davidstirling777-star/Underwater-Hockey-Scoring-Desk-Kit/hardware/Enclosures/UWH_Siren/UWH_Siren_Pipe_Adaptor.step

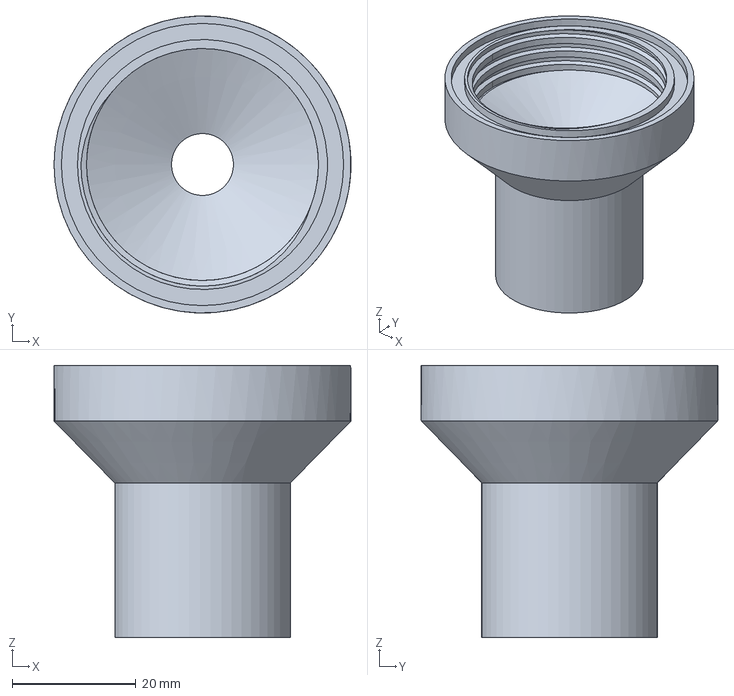
[picture p3: CAD file, 2026-11-10]
hardware/Enclosures/UWH_Siren/UWH_Siren_Pipe_Adaptor.step
48.0 x 48.0 x 44.0 mm
