davidstirling777-star/Underwater-Hockey-Scoring-Desk-Kit/(threads)

Thread 45 (2025-09-18):

create Zigbee/WiFi communications

davidstirling777-star, 2025-09-18:
no idea how to do this, I have a sonoff zigbee dongle to play with, but as of 18 September 2025, no zigbee buttons.  Should we just use the WIFI capability of the RP5 and use wifi buttons?

davidstirling777-star, 2025-09-26:
import subprocess

SSID = "UWH"
PASSWORD = "stickandpuck"
INTERFACE = "wlan0"  # Change if your Wi-Fi interface is different

def create_wifi_hotspot(ssid, password, interface):
    try:
        subprocess.run(['rfkill', 'unblock', 'wifi'], check=True)
        subprocess.run(['nmcli', 'radio', 'wifi', 'on'], check=True)
        subprocess.run([
            'nmcli', 'device', 'wifi', 'hotspot',
            'ifname', interface,
            'ssid', ssid,
            'password', password
        ], check=True)
        print(f"Hotspot '{ssid}' created with password '{password}' on {interface}.")
    except subprocess.CalledProcessError as e:
        print(f"Failed to create hotspot: {e}")

if __name__ == "__main__":
    create_wifi_hotspot(SSID, PASSWORD, INTERFACE)

Closed 2025-09-26.

Thread 54 (2025-09-20):

Starting a game at a set time

davidstirling777-star, 2025-09-20:
At the moment the app just starts the game sequence after Between Game Break value.

It would be nice to be able to set a time that the game started at and get the app to count down to that time, but actually swapping over to Between Game Break at that variables value before the scheduled start time,

eg, Current time is 7:15 am, Games start at 8:00 am, countdown timer displays 45:00 (mm:ss) but at 7:55 am the app swaps into Between Game Break as this value is set to (say) 5 minutes,

Thread 56 (2025-09-20):

Ability to 'step-through" a game

davidstirling777-star, 2025-09-20:
Occasionally things will get stuffed up by the score keeper so there should be a way of coping with the situation where say, game 64, a goal was inadvertently added in the last seconds of the game or overtime break (or Sudden Death Game Break) that tied the scores and the game progresses to Between Game Break, rather than Overtime Game Break.
Maybe a text box in the Game variables page where the game number could be entered and an advance button to step through the game sequence, then a GAME PAUSED/ ADD GOALS button appears on the Scoreboard screen so the score can be recreated, before the button is pushed (and vanishes) and a short countdown timer appears (say 10 seconds) with sound pips?

davidstirling777-star, 2025-10-06:
I don't think the current system has any ability to step through a game.  Like this system, it can start at a particular game from a list.
