davidstirling777-star/Underwater-Hockey-Scoring-Desk-Kit/hardware/Boards/DC-DC PDM-Audio/DC-DC PDM-Audio.kicad_pcb

## KiCad design hardware/Boards/DC-DC PDM-Audio/DC-DC PDM-Audio.kicad_pcb (2026-11-12)

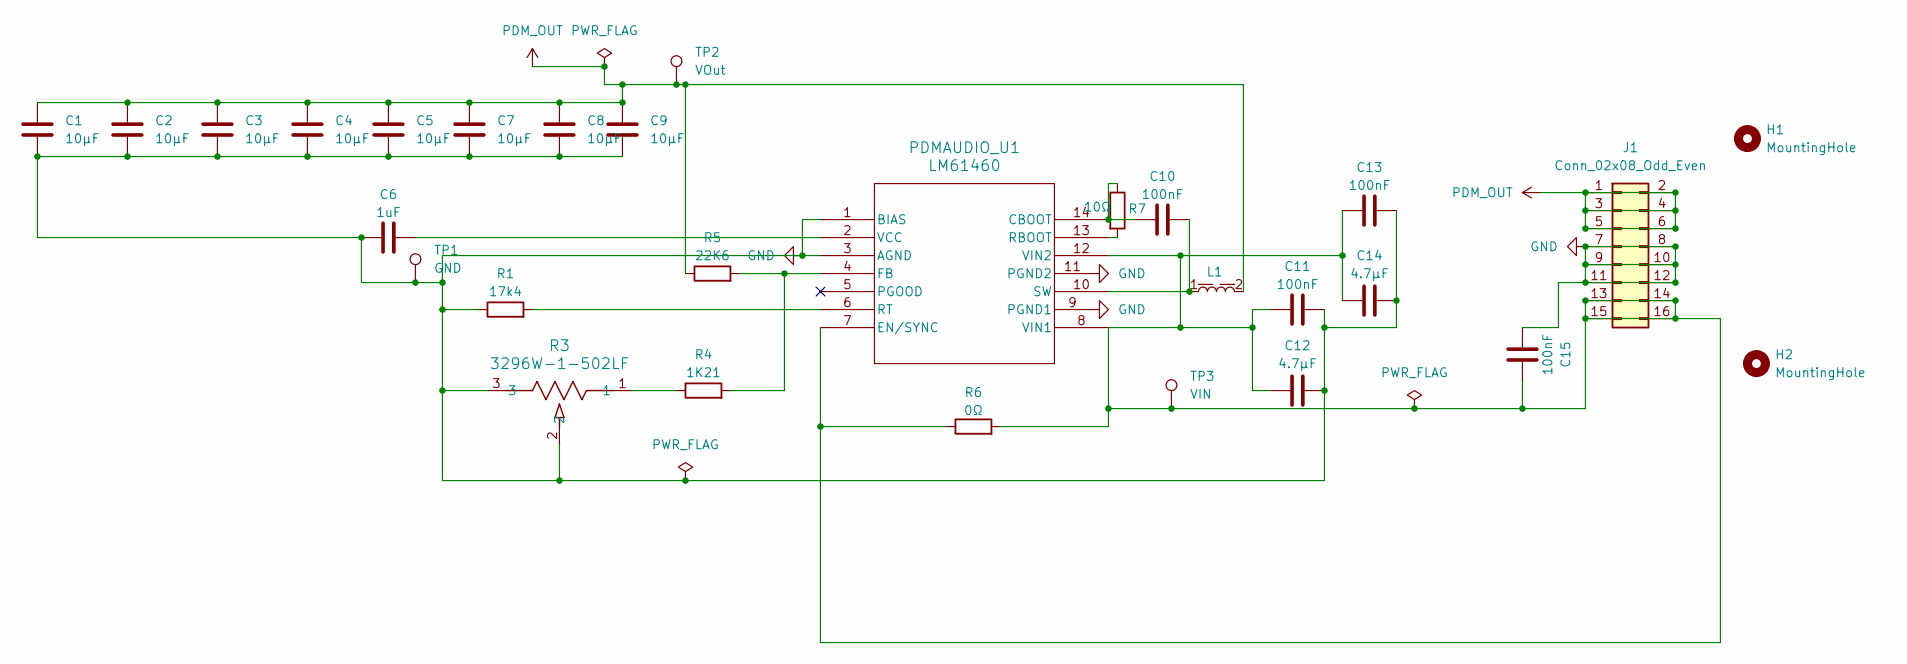
[picture p4: schematic DC-DC PDM-Audio.kicad_sch]

Parts:
C1, C2, C3, C4, C5, C7, C8, C9: 10µF; C_1210_3225Metric; MPN GRJ32ER71H106KE11K
C6: 1uF; C_0603_1608Metric; MPN GCM188R71C105KA64D
C10: 100nF; C_0805_2012Metric; MPN GCM21BR71H104KA37L
C11, C13, C15: 100nF; C_0603_1608Metric; MPN GCM188R71H104KA57D
C12, C14: 4.7µF; C_1206_3216Metric; MPN GRM31CR71H475KA12L
H1, H2: MountingHole; MountingHole_3.2mm_M3
J1: Conn_02x08_Odd_Even; PinHeader_2x08_P2.54mm_Vertical; MPN TSW-108-07-F-D
L1: 744393665100; Wurth_744393665100_WE-XHMI_1060; MPN 744393665100
PDMAUDIO_U1: LM61460; VQFN-HR14_RJR_TEX; MPN LMQ61460AFSQRJRRQ1
R1: 17k4; R_0603_1608Metric; MPN RC0603FR-0717K4L
R3: 3296W-1-502LF; Potentiometer_Bourns_3296W_Vertical; MPN 3296W-1-502LF
R4: 1K21; R_0603_1608Metric_Pad0.98x0.95mm_HandSolder; MPN RT0603BRE071K21L
R5: 22K6; R_0603_1608Metric_Pad0.98x0.95mm_HandSolder; MPN RT0603BRD0722K6L
R6: 0Ω; R_0603_1608Metric; MPN RC0603JR-070RL
R7: 10Ω; R_0603_1608Metric; MPN AC0603FR-0710RL
TP1: GND; TestPoint_Pad_D1.5mm
TP2: VOut; TestPoint_Pad_D1.5mm
TP3: VIN; TestPoint_Pad_D1.5mm

Connections:
GND: C1.2, C2.2, C3.2, C4.2, C5.2, C6.1, C7.2, C8.2, C9.2, C11.2, C12.2, C13.2, C14.2, C15.1, J1.7, J1.8, J1.9, J1.10, J1.11, J1.12, PDMAUDIO_U1.1 (BIAS), PDMAUDIO_U1.3 (AGND), PDMAUDIO_U1.9 (PGND1), PDMAUDIO_U1.11 (PGND2), R1.1, R3.2, R3.3, TP1.1 (1_1)
unnamed: C11.1, C12.1, C13.1, C14.1, C15.2, J1.13, J1.14, J1.15, J1.16, PDMAUDIO_U1.7 (EN/SYNC), PDMAUDIO_U1.8 (VIN1), PDMAUDIO_U1.12 (VIN2), R6.1, R6.2, TP3.1 (1_1)
unnamed: C10.1, PDMAUDIO_U1.14 (CBOOT), R7.1
unnamed: PDMAUDIO_U1.4 (FB), R4.2, R5.2
unnamed: PDMAUDIO_U1.13 (RBOOT), R7.2
unnamed: PDMAUDIO_U1.6 (RT), R1.2
unnamed: C10.2, L1.1, PDMAUDIO_U1.10 (SW)
unnamed: C6.2, PDMAUDIO_U1.2 (VCC)
unnamed: R3.1, R4.1
PDM_OUT: C1.1, C2.1, C3.1, C4.1, C5.1, C7.1, C8.1, C9.1, J1.1, J1.2, J1.3, J1.4, J1.5, J1.6, L1.2, R5.1, TP2.1 (1_1)

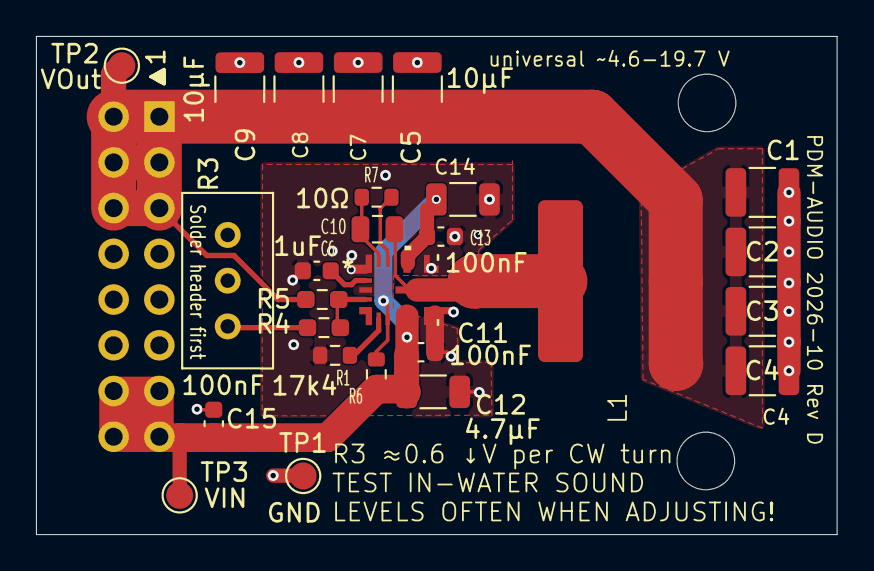
[picture p5: board DC-DC PDM-Audio.kicad_pcb from above]

Board: 2 copper layers, 44.5 x 27.7 mm, 29 parts (1 on the bottom side), 10 nets.
