davidstirling777-star/Underwater-Hockey-Scoring-Desk-Kit/hardware/Boards/UWH Power Board/UWH Power Board.kicad_pcb

## KiCad design hardware/Boards/UWH Power Board/UWH Power Board.kicad_pcb (2026-11-08)

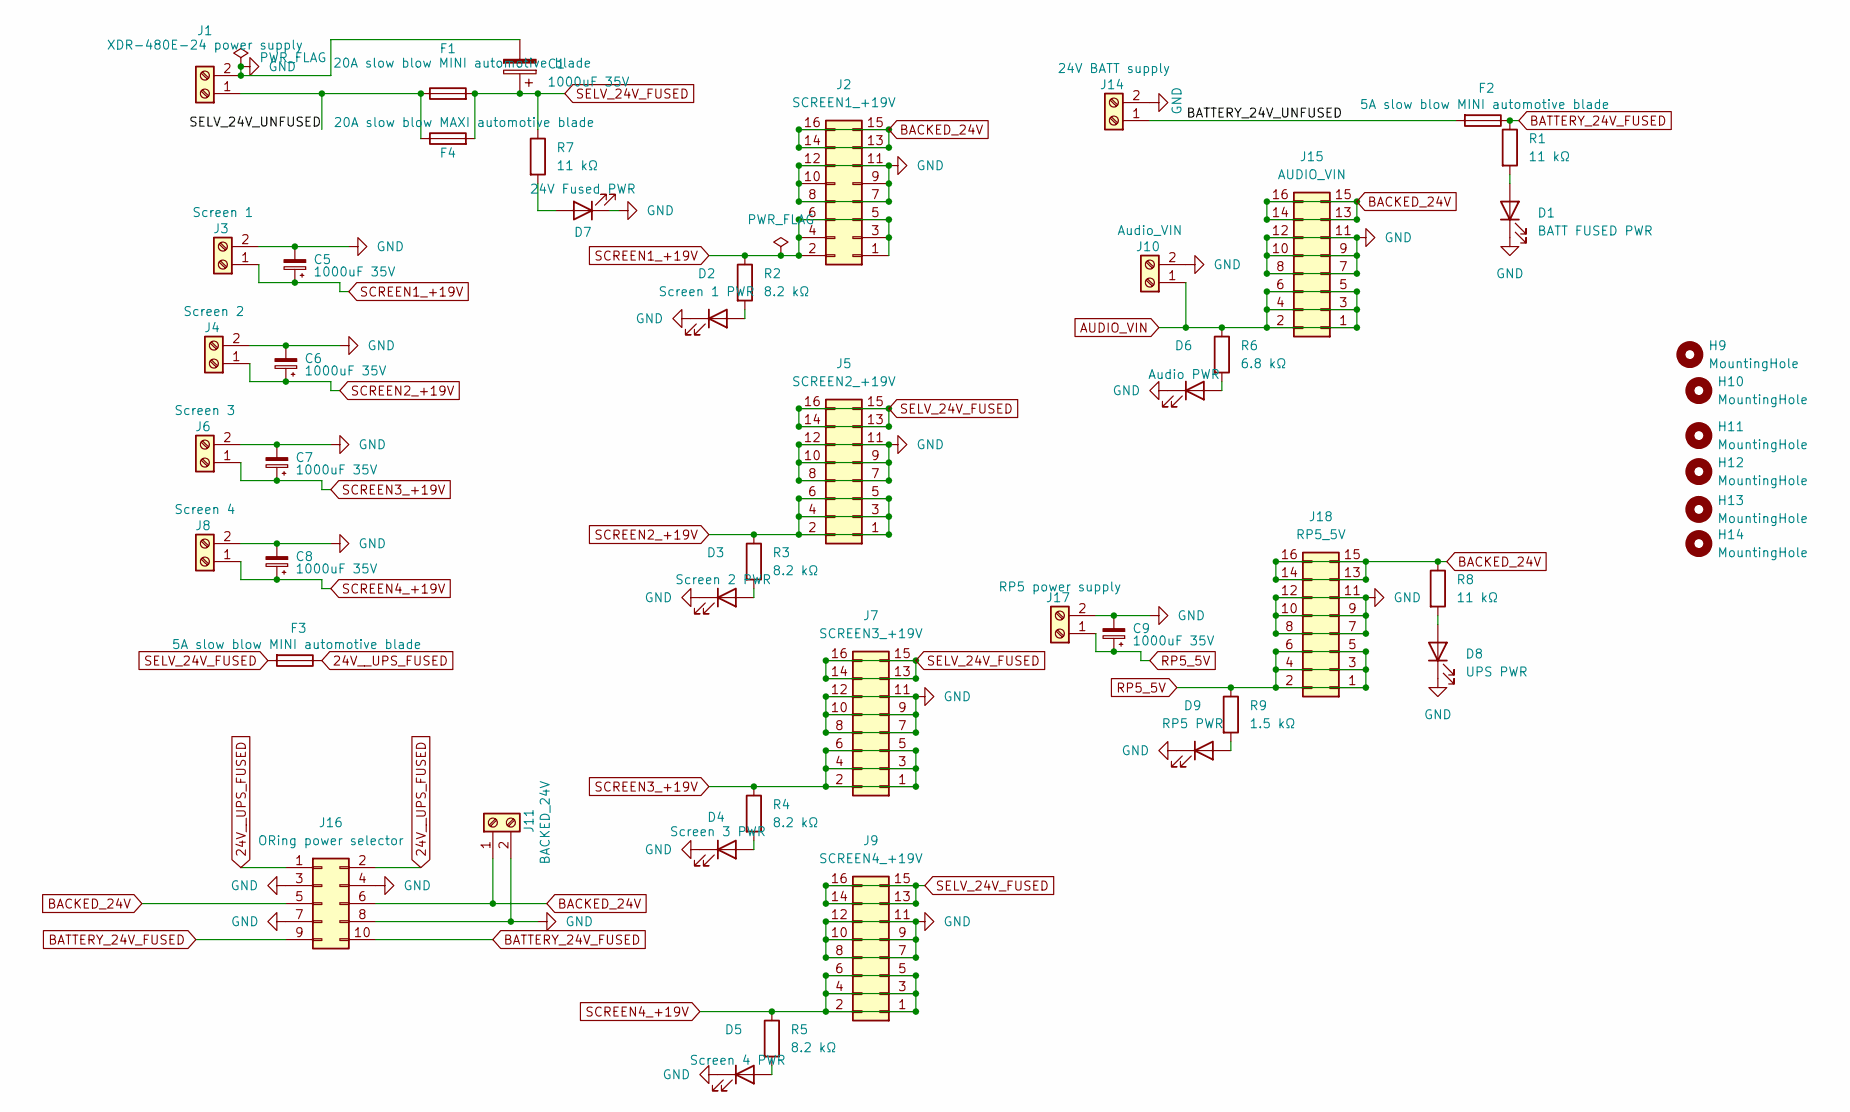
[picture p6: schematic UWH Power Board.kicad_sch]

Parts:
C1, C5, C6, C7, C8, C9: 1000uF 35V; CP_Radial_D12.5mm_P5.00mm; MPN 35ZLH1000MEFC12.5X20
D1: BATT FUSED PWR; LED_D3.0mm; MPN WP710A10LCGDK
D2: Screen 1 PWR; LED_D3.0mm; MPN WP710A10LCGDK
D3: Screen 2 PWR; LED_D3.0mm; MPN WP710A10LCGDK
D4: Screen 3 PWR; LED_D3.0mm; MPN WP710A10LCGDK
D5: Screen 4 PWR; LED_D3.0mm; MPN WP710A10LCGDK
D6: Audio PWR; LED_D3.0mm; MPN WP710A10LCGDK
D7: 24V Fused PWR; LED_D3.0mm; MPN WP710A10LCGDK
D8: UPS PWR; LED_D3.0mm; MPN WP710A10LCGDK
D9: RP5 PWR; LED_D3.0mm; MPN WP710A10LCGDK
F1: 20A slow blow MINI automotive blade; Fuseholder_Blade_Mini_Keystone_3568; MPN 3568
F2, F3: 5A slow blow MINI automotive blade; Fuseholder_Blade_Mini_Keystone_3568; MPN 3568
F4: 20A slow blow MAXI automotive blade; Fuseholder_Keystone_3555-2; MPN 3555-2
H9, H10, H11, H12, H13, H14: MountingHole; MountingHole_3.2mm_M3_Clearance7.2mm
J1: XDR-480E-24 power supply; CONN_1714971_PXC; MPN 1714971
J2: SCREEN1_+19V; PinSocket_2x08_P2.54mm_Vertical; MPN SSW-108-02-G-D
J3: Screen 1; TerminalBlock_CUI_TB007-508-02_1x02_P5.08mm_Horizontal; MPN TB007-508-02BE
J4: Screen 2; TerminalBlock_CUI_TB007-508-02_1x02_P5.08mm_Horizontal; MPN TB007-508-02BE
J5: SCREEN2_+19V; PinSocket_2x08_P2.54mm_Vertical; MPN SSW-108-02-G-D
J6: Screen 3; TerminalBlock_CUI_TB007-508-02_1x02_P5.08mm_Horizontal; MPN TB007-508-02BE
J7: SCREEN3_+19V; PinSocket_2x08_P2.54mm_Vertical; MPN SSW-108-02-G-D
J8: Screen 4; TerminalBlock_CUI_TB007-508-02_1x02_P5.08mm_Horizontal; MPN TB007-508-02BE
J9: SCREEN4_+19V; PinSocket_2x08_P2.54mm_Vertical; MPN SSW-108-02-G-D
J10: Audio_VIN; TerminalBlock_CUI_TB007-508-02_1x02_P5.08mm_Horizontal; MPN TB007-508-02BE
J11: BACKED_24V; TerminalBlock_CUI_TB007-508-02_1x02_P5.08mm_Horizontal; MPN TB007-508-02BE
J14: 24V BATT supply; TerminalBlock_CUI_TB007-508-02_1x02_P5.08mm_Horizontal; MPN TB007-508-02BE
J15: AUDIO_VIN; PinSocket_2x08_P2.54mm_Vertical; MPN SSW-108-02-G-D
J16: ORing power selector; ORing_Socket_SSW-105-02-G-D_v5; MPN SSW-105-02-G-D
J17: RP5 power supply; TerminalBlock_CUI_TB007-508-02_1x02_P5.08mm_Horizontal; MPN TB007-508-02BE
J18: RP5_5V; PinSocket_2x08_P2.54mm_Vertical; MPN SSW-108-02-G-D
R1, R7, R8: 11 kΩ; R_Axial_DIN0207_L6.3mm_D2.5mm_P7.62mm_Horizontal; MPN MFR-25FRF52-11K
R2, R3, R4, R5: 8.2 kΩ; R_Axial_DIN0207_L6.3mm_D2.5mm_P7.62mm_Horizontal; MPN MFR-25FRF52-8K2
R6: 6.8 kΩ; R_Axial_DIN0207_L6.3mm_D2.5mm_P7.62mm_Horizontal; MPN MFR-25FRF52-6K8
R9: 1.5 kΩ; R_Axial_DIN0207_L6.3mm_D2.5mm_P7.62mm_Horizontal; MPN MFR-25FRF52-1K5

Connections:
24V__UPS_FUSED: F3.1, J16.1, J16.2
/BATTERY_24V_UNFUSED: F2.2, J14.1
/SELV_24V_UNFUSED: F1.1, F4.1, J1.1
AUDIO_VIN: J10.1, J15.1, J15.2, J15.3, J15.4, J15.5, J15.6, R6.1
BACKED_24V: J2.13, J2.14, J2.15, J2.16, J11.1, J15.13, J15.14, J15.15, J15.16, J16.5, J16.6, J18.13, J18.14, J18.15, J18.16, R8.1
BATTERY_24V_FUSED: F2.1, J16.9, J16.10, R1.1
GND: C1.2, C5.2, C6.2, C7.2, C8.2, C9.2, D1.1 (K), D2.1 (K), D3.1 (K), D4.1 (K), D5.1 (K), D6.1 (K), D7.1 (K), D8.1 (K), D9.1 (K), J1.2, J2.7, J2.8, J2.9, J2.10, J2.11, J2.12, J3.2, J4.2, J5.7, J5.8, J5.9, J5.10, J5.11, J5.12, J6.2, J7.7, J7.8, J7.9, J7.10, J7.11, J7.12, J8.2, J9.7, J9.8, J9.9, J9.10, J9.11, J9.12, J10.2, J11.2, J14.2, J15.7, J15.8, J15.9, J15.10, J15.11, J15.12, J16.3, J16.4, J16.7, J16.8, J17.2, J18.7, J18.8, J18.9, J18.10, J18.11, J18.12
unnamed: D1.2 (A), R1.2
unnamed: D2.2 (A), R2.2
unnamed: D3.2 (A), R3.2
unnamed: D4.2 (A), R4.2
unnamed: D5.2 (A), R5.2
unnamed: D6.2 (A), R6.2
unnamed: D7.2 (A), R7.2
unnamed: D8.2 (A), R8.2
unnamed: D9.2 (A), R9.2
RP5_5V: C9.1, J17.1, J18.1, J18.2, J18.3, J18.4, J18.5, J18.6, R9.1
SCREEN1_+19V: C5.1, J2.1, J2.2, J2.3, J2.4, J2.5, J2.6, J3.1, R2.1
SCREEN2_+19V: C6.1, J4.1, J5.1, J5.2, J5.3, J5.4, J5.5, J5.6, R3.1
SCREEN3_+19V: C7.1, J6.1, J7.1, J7.2, J7.3, J7.4, J7.5, J7.6, R4.1
SCREEN4_+19V: C8.1, J8.1, J9.1, J9.2, J9.3, J9.4, J9.5, J9.6, R5.1
SELV_24V_FUSED: C1.1, F1.2, F3.2, F4.2, J5.13, J5.14, J5.15, J5.16, J7.13, J7.14, J7.15, J7.16, J9.13, J9.14, J9.15, J9.16, R7.1

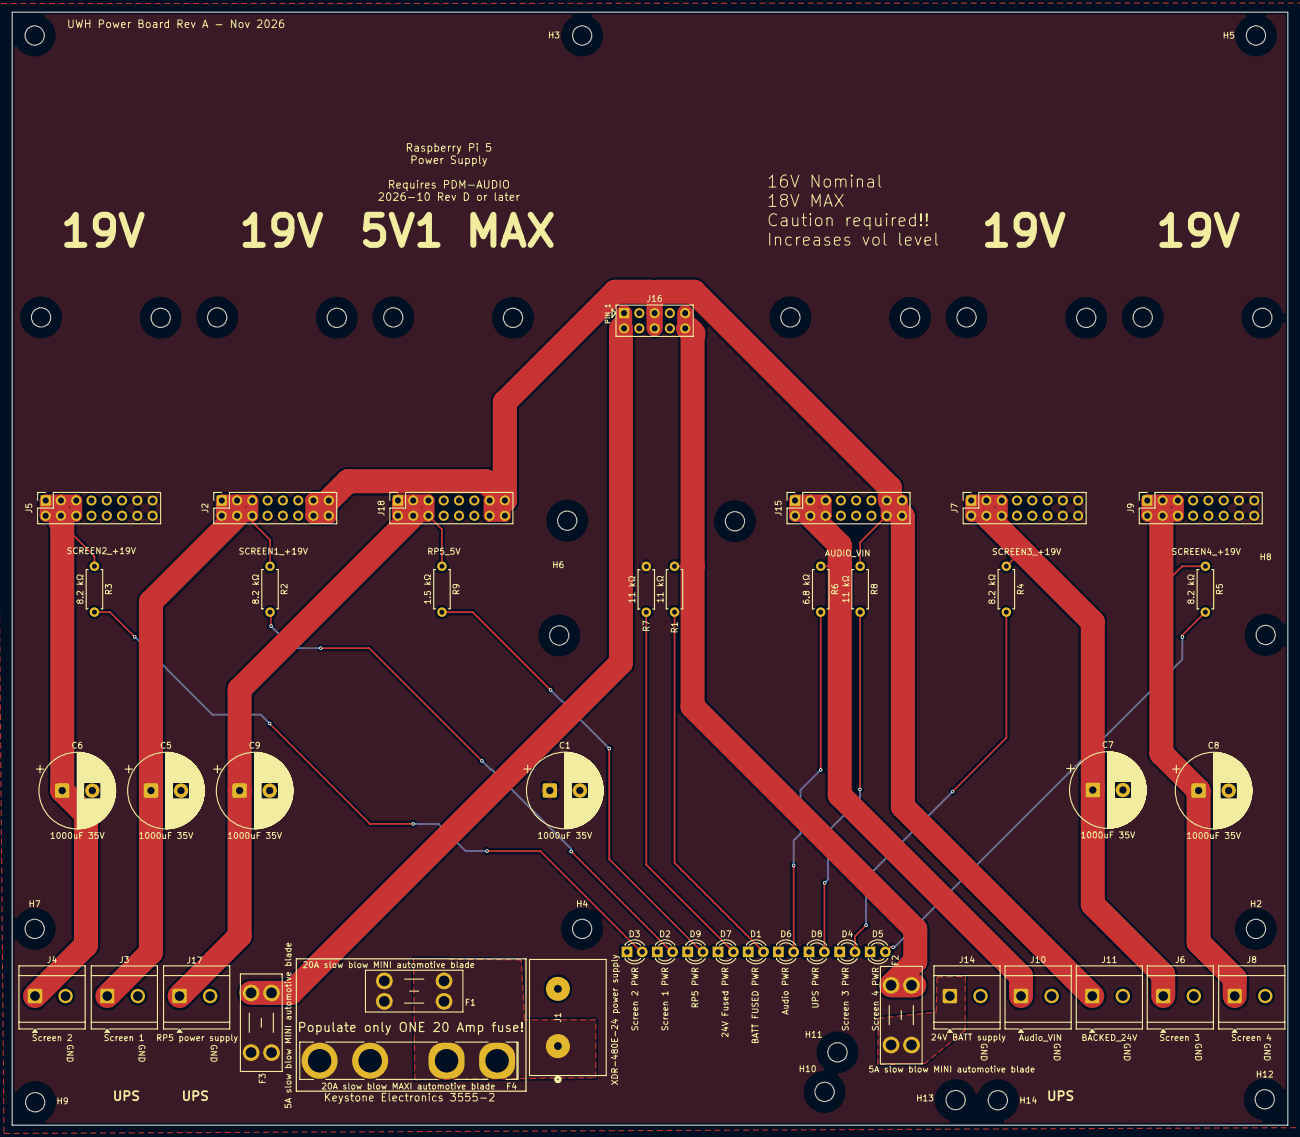
[picture p7: board UWH Power Board.kicad_pcb from above]

Board: 2 copper layers, 212.0 x 185.0 mm, 58 parts (0 on the bottom side), 22 nets.

Other parts of the board:
H1, H2, H3, H4, H5, H6, H7, H8: MountingHole; MountingHole_3.2mm_M3_Clearance7.2mm
