davidstirling777-star/Underwater-Hockey-Scoring-Desk-Kit/zigbee_siren.py

"""Zigbee2MQTT wireless siren integration and optional MQTT siren output.

Zigbee2MQTT owns the coordinator radio/serial port and publishes per-device
MQTT actions. This Paho client never opens that port. Only devices listed in
Button Device Names are accepted for siren actions; only explicit per-device
action mappings may create events. Unknown device/action observations are
logged and held for Auto-add From Log, which starts them as Ignore. Callbacks
run on a background thread and must
queue UI/audio events rather than directly operate Tk or pygame.

The separately named Siren Device is an optional MQTT OUTPUT for hardware
ON/OFF commands; it is not one of the input referee buttons.
serial_siren_listener.py is the lead USB-port detector and Arduino reader.
"""

import threading
import time
import logging
import json
import queue
import os
import sys
import platform
import settings_manager
from typing import Optional, Callable, Dict, Any

# =============================================================================
# HARDWARE COMMUNICATION LAYER
# =============================================================================
#
# This module owns low-level siren hardware communication.
#
# Responsibilities:
# - Detect and remember Arduino and Zigbee COM ports
# - Listen for Arduino serial SIREN_ON / SIREN_OFF events
# - Manage MQTT connection to Zigbee2MQTT
# - Subscribe to Zigbee button events
# - Publish Zigbee siren ON / OFF payloads
# - Report status changes via callbacks
#
# This module must NOT:
# - Modify Tkinter widgets directly
# - Call pygame directly
# - Play local app audio directly
# - Update scoreboard/game state directly
#
# Instead, it should notify uwh.py through callbacks:
# - siren_callback("ON")
# - siren_callback("OFF")
# - siren_callback("PULSE") for a single wireless click
# - siren_callback("DOUBLE_PULSE") for two timed wireless siren blasts
# - gui_log_callback(message)
# - connection_status_callback(connected, message)
#
# uwh.py remains responsible for:
# - Tkinter UI updates
# - Local sound playback
# - Game timer/display updates
# - CSV export
#
# =============================================================================

# Hardware event names sent back to uwh.py
SIREN_EVENT_ON = "ON"
SIREN_EVENT_OFF = "OFF"
SIREN_EVENT_PULSE = "PULSE"
SIREN_EVENT_DOUBLE_PULSE = "DOUBLE_PULSE"
SIREN_EVENT_TEST = "TEST"

# MQTT actions are matched for each configured device. Unknown actions have no
# effect until a referee explicitly adds an action mapping in the UI.
ACTION_TO_EVENT = {
    "one_cycle": SIREN_EVENT_PULSE,
    "two_cycles": SIREN_EVENT_DOUBLE_PULSE,
}
MAPPING_ACTIONS = frozenset((
    "one_cycle", "two_cycles", "start_continuous",
    "stop_continuous", "ignore",
))
LEGACY_BUTTON_ACTIONS = {
    "single": "one_cycle", "press": "one_cycle", "click": "one_cycle",
    "on": "one_cycle", "1": "one_cycle", "hold": "one_cycle",
    "emergency": "one_cycle", "double": "two_cycles",
}


def normalize_action_mappings(raw_mappings):
    """Return valid unique device/action mappings without executing bad actions."""
    if not isinstance(raw_mappings, list):
        return []
    result = []
    seen = set()
    for row in raw_mappings:
        if not isinstance(row, dict):
            continue
        device = str(row.get("device", "")).strip()
        action = str(row.get("action", "")).strip().lower()
        uwh_action = str(row.get("uwh_action", "")).strip()
        if not device or not action or uwh_action not in MAPPING_ACTIONS:
            continue
        if len(device) > 128 or len(action) > 128:
            continue
        key = (device, action)
        if key in seen:
            continue
        seen.add(key)
        result.append({"device": device, "action": action,
                       "uwh_action": uwh_action,
                       "notes": str(row.get("notes", ""))[:200]})
    return result


def legacy_action_mappings(devices):
    """Seed existing button behaviour when an older settings.json is upgraded.

    The controller had previously recognised these actions on ANY allowed
    button. Explicit per-device rows preserve that behaviour when migrating.
    """
    result = []
    for device in dict.fromkeys(devices):
        if not isinstance(device, str) or not device.strip():
            continue
        device = device.strip()
        for action, uwh_action in LEGACY_BUTTON_ACTIONS.items():
            result.append({"device": device, "action": action,
                           "uwh_action": uwh_action, "notes": "Legacy behaviour"})
    return result


try:
    import paho.mqtt.client as mqtt
    MQTT_AVAILABLE = True
except ImportError:
    MQTT_AVAILABLE = False
    mqtt = None

try:
    import serial
    PYSERIAL_AVAILABLE = True
except ImportError:
    PYSERIAL_AVAILABLE = False
    serial = None

try:
    import serial_siren_listener
except Exception:
    serial_siren_listener = None

CURRENT_PLATFORM = platform.system()
IS_WINDOWS = CURRENT_PLATFORM == "Windows"
IS_LINUX = CURRENT_PLATFORM == "Linux"

SETTINGS_FILE = "settings.json"
ZIGBEE_CONFIG_FILE = "zigbee_config.json"


def _settings_directory():
    # Match uwh.py / settings_manager.py: do not silently load a different
    # settings.json when started by a desktop shortcut with another CWD.
    if getattr(sys, "frozen", False):
        return os.path.dirname(os.path.abspath(sys.executable))
    return os.path.dirname(os.path.abspath(__file__))

DEFAULT_CONFIG = {
    "mqtt_broker": "localhost",
    "mqtt_port": 1883,
    "mqtt_username": "",
    "mqtt_password": "",
    "mqtt_topic": "zigbee2mqtt/+",
    "siren_button_devices": ["siren_button"],
    "siren_button_device": "siren_button",
    "siren_device_name": "zigbee_siren",
    "connection_timeout": 60,
    "reconnect_delay": 5,
    "enable_logging": True,
    "serial_port": "",
    "serial_baudrate": 115200,
    "serial_timeout": 1.0,
    "use_serial_fallback": True,
    "prefer_mqtt": True,
}

def get_zigbee_port_from_lead_detector():
    """Get Zigbee COM port from serial_siren_listener, if available."""
    try:
        if serial_siren_listener:
            return serial_siren_listener.get_zigbee_port()
    except Exception as e:
        print(f"Could not get Zigbee port from serial_siren_listener: {e}")

    return ""


class ZigbeeSirenController:
    """Controls wireless siren functionality through Zigbee2MQTT."""

    def __init__(
        self,
        siren_callback: Optional[Callable] = None,
        gui_log_callback: Optional[Callable[[str], None]] = None
    ):
        """Create the MQTT controller and the worker-to-GUI event handoff.
        """
        self.siren_callback = siren_callback
        self.gui_log_callback = gui_log_callback
        self.mqtt_client: Optional[mqtt.Client] = None
        self.connected = False
        self.connection_thread: Optional[threading.Thread] = None
        self.should_stop = threading.Event()
        self.connection_status_callback: Optional[Callable[[bool, str], None]] = None

        self.logger = logging.getLogger(__name__)
        logging.basicConfig(
            level=logging.INFO,
            format="%(asctime)s - %(name)s - %(levelname)s - %(message)s"
        )

        self.logger.info(f"Zigbee controller initializing on {CURRENT_PLATFORM}")

        self.config = self.load_config()
        # A Queue protects observation of unfamiliar actions by the MQTT thread.
        # Only the Tk thread ever reads and edits the table itself.
        self.unmapped_actions = queue.Queue(maxsize=200)

        if not self.config.get("serial_port"):
            self.config["serial_port"] = get_zigbee_port_from_lead_detector()

        self.logger.setLevel(
            logging.INFO if self.config.get("enable_logging", True) else logging.WARNING
        )

        if not MQTT_AVAILABLE:
            self.logger.warning("paho-mqtt not available. Zigbee siren functionality disabled.")

    def _migrate_device_config(self, config: Dict[str, Any]) -> Dict[str, Any]:
        """Turn legacy single-device settings into an explicit device/action map.
        """
        if "siren_button_device" in config and "siren_button_devices" not in config:
            single_device = config["siren_button_device"]
            if isinstance(single_device, str) and single_device:
                config["siren_button_devices"] = [single_device]
                self.logger.info(
                    f"Migrated single device '{single_device}' to device list format"
                )

        if "siren_button_devices" in config and "siren_button_device" not in config:
            device_list = config["siren_button_devices"]
            if isinstance(device_list, list) and device_list:
                config["siren_button_device"] = device_list[0]

        if "siren_button_devices" not in config:
            config["siren_button_devices"] = [
                config.get("siren_button_device", "siren_button")
            ]
        elif isinstance(config["siren_button_devices"], str):
            config["siren_button_devices"] = [config["siren_button_devices"]]

        # Absence of action_mappings identifies a pre-mapping installation.
        # Once users save mappings, even an empty list is authoritative.
        if "action_mappings" not in config:
            devices = config.get("siren_button_devices", [])
            if not isinstance(devices, list):
                devices = [devices]
            legacy = config.get("siren_button_device", "")
            if legacy and legacy not in devices:
                devices.append(legacy)
            config["action_mappings"] = legacy_action_mappings(devices)
        else:
            config["action_mappings"] = normalize_action_mappings(
                config["action_mappings"]
            )
        return config

    def load_config(self) -> Dict[str, Any]:
        """Read the unified Zigbee section and migrate older settings if necessary.
        """
        settings_path = os.path.join(_settings_directory(), SETTINGS_FILE)

        if os.path.exists(settings_path):
            try:
                with open(settings_path, "r", encoding="utf-8") as f:
                    unified_settings = json.load(f)

                config = unified_settings.get("zigbeeSettings", {})
                if config:
                    config = self._migrate_device_config(config)
                    merged_config = DEFAULT_CONFIG.copy()
                    merged_config.update(config)
                    return merged_config

            except Exception as e:
                self.logger.error(f"Error loading unified config: {e}. Trying legacy file.")

        legacy_path = os.path.join(_settings_directory(), ZIGBEE_CONFIG_FILE)

        if os.path.exists(legacy_path):
            try:
                with open(legacy_path, "r", encoding="utf-8") as f:
                    config = json.load(f)

                config = self._migrate_device_config(config)
                merged_config = DEFAULT_CONFIG.copy()
                merged_config.update(config)
                self.save_config(merged_config)
                return merged_config

            except Exception as e:
                self.logger.error(f"Error loading legacy config: {e}. Using defaults.")

        default_config = DEFAULT_CONFIG.copy()
        default_config = self._migrate_device_config(default_config)
        self.save_config(default_config)
        return default_config

    def save_config(self, config: Dict[str, Any]) -> None:
        """Use the shared, backup-protected settings writer.

        A damaged existing settings.json must not be replaced by an empty
        document; notify callers if saving failed.
        """
        try:
            settings_dir = _settings_directory()
            unified_settings = settings_manager.load_unified_settings(
                settings_dir
            )
            unified_settings.setdefault("zigbeeSettings", {})
            unified_settings.setdefault("soundSettings", {})
            unified_settings.setdefault("gameSettings", {})
            unified_settings["zigbeeSettings"] = config

            settings_manager.save_unified_settings(
                settings_dir, unified_settings
            )
            self.config = config

        except Exception as error:
            self.logger.error(f"Error saving config: {error}")
            raise

    def set_siren_callback(self, callback: Callable) -> None:
        self.siren_callback = callback

    def set_connection_status_callback(
        self,
        callback: Callable[[bool, str], None]
    ) -> None:
        self.connection_status_callback = callback

    def start(self) -> bool:
        """Start the background MQTT connection worker without blocking Tk.
        """
        if not MQTT_AVAILABLE:
            self._notify_status(False, "MQTT library not available")
            return False

        if self.connection_thread and self.connection_thread.is_alive():
            self.logger.warning("Controller already running")
            return True

        self.should_stop.clear()
        self.connection_thread = threading.Thread(
            target=self._connection_loop,
            daemon=True
        )
        self.connection_thread.start()

        self.logger.info("Zigbee siren controller started")
        return True

    def stop(self) -> None:
        """Stop connection retries and close this MQTT client's session.
        """
        self.should_stop.set()

        if self.mqtt_client and self.connected:
            try:
                self.mqtt_client.disconnect()
            except Exception as e:
                self.logger.error(f"Error disconnecting MQTT client: {e}")

        if self.connection_thread and self.connection_thread.is_alive():
            self.connection_thread.join(timeout=5)

        self.connected = False
        self._trigger_siren("WIRELESS_MQTT_DISCONNECT")
        self._notify_status(False, "Stopped")
        self.logger.info("Zigbee siren controller stopped")

    def _connection_loop(self) -> None:
        """Retry the broker connection until stopped; never own the USB radio.
        """
        while not self.should_stop.is_set():
            try:
                self._setup_mqtt_client()
                self._connect_mqtt()

                while self.connected and not self.should_stop.is_set():
                    time.sleep(1)

            except Exception as e:
                self.logger.error(f"Connection error: {e}")
                self._notify_status(False, f"Error: {e}")

            if not self.should_stop.is_set():
                delay = self.config.get("reconnect_delay", 5)
                self.logger.info(f"Reconnecting in {delay} seconds...")
                time.sleep(delay)

    def _setup_mqtt_client(self) -> None:
        """Configure Paho with the saved broker credentials and callbacks.
        """
        self.mqtt_client = mqtt.Client()

        if self.config.get("mqtt_username"):
            self.mqtt_client.username_pw_set(
                self.config.get("mqtt_username", ""),
                self.config.get("mqtt_password", "")
            )

        self.mqtt_client.on_connect = self._on_connect
        self.mqtt_client.on_disconnect = self._on_disconnect
        self.mqtt_client.on_message = self._on_message

        self.mqtt_client.connect_async(
            self.config.get("mqtt_broker", "localhost"),
            int(self.config.get("mqtt_port", 1883)),
            int(self.config.get("connection_timeout", 60))
        )

    def _connect_mqtt(self) -> None:
        """Attempt the configured broker connection and await its status.
        """
        self.mqtt_client.loop_start()

        timeout = time.time() + int(self.config.get("connection_timeout", 60))

        while (
            not self.connected
            and time.time() < timeout
            and not self.should_stop.is_set()
        ):
            time.sleep(0.1)

        if not self.connected:
            try:
                self.mqtt_client.loop_stop()
            except Exception:
                pass
            raise Exception("Connection timeout")

    def _on_connect(self, client, userdata, flags, rc) -> None:
        """Record a broker session and subscribe to the configured topic.
        """
        if rc == 0:
            self.connected = True

            broker = self.config.get("mqtt_broker", "localhost")
            port = self.config.get("mqtt_port", 1883)

            self.logger.info(f"Connected to MQTT broker {broker}:{port}")

            topic = self.config.get("mqtt_topic", "zigbee2mqtt/+")
            client.subscribe(topic)

            self.logger.info(f"Subscribed to topic: {topic}")
            self._notify_status(True, "Connected")

        else:
            self.connected = False
            self.logger.error(f"Failed to connect to MQTT broker. Return code: {rc}")
            self._notify_status(False, f"Connection failed (RC: {rc})")

    def _on_disconnect(self, client, userdata, rc) -> None:
        """Mark the session unavailable; a lost release must stop a hold.
        """
        was_connected = self.connected
        self.connected = False
        if was_connected:
            # A continuous siren must not depend on a release arriving after
            # the MQTT link fails. This callback never touches Tk directly.
            self._trigger_siren("WIRELESS_MQTT_DISCONNECT")

        if rc != 0:
            self.logger.warning(f"Unexpected disconnection from MQTT broker. RC: {rc}")
            self._notify_status(False, "Disconnected unexpectedly")
        else:
            self.logger.info("Disconnected from MQTT broker")
            self._notify_status(False, "Disconnected")

    def _on_message(self, client, userdata, msg) -> None:
        """Only allow listed button names through to their action mappings.
        """
        try:
            topic = msg.topic
            payload = msg.payload.decode("utf-8")

            try:
                data = json.loads(payload)
            except json.JSONDecodeError:
                self.logger.warning(f"Invalid JSON in message: {payload}")
                return

            device_name = topic.split("/")[-1]
            raw_devices = self.config.get("siren_button_devices", [])
            configured_devices = (list(raw_devices) if isinstance(raw_devices, list)
                                  else [str(raw_devices)])

            legacy_device = self.config.get("siren_button_device", "")
            if legacy_device and legacy_device not in configured_devices:
                configured_devices.append(legacy_device)

            if device_name in configured_devices:
                self._process_button_event(device_name, data)
            elif isinstance(data, dict):
                # A Zigbee2MQTT message from an unlisted button otherwise
                # disappears silently before the action-mapping code runs.
                # Stay fail-closed: only the operator can add a device.
                action = data.get("action")
                if isinstance(action, str) and action.strip():
                    msg = (
                        f"Ignored Zigbee button '{device_name}' action "
                        f"'{action}': device is not in Button Device Names."
                    )
                    self.logger.warning(msg)
                    if self.gui_log_callback:
                        self.gui_log_callback(msg)

                    # Record the observed action for the operator's explicit
                    # Auto-add From Log workflow. This remains fail-closed:
                    # merely observing an unlisted device never enables it or
                    # plays a siren.
                    action_name = action.strip().lower()
                    try:
                        self.unmapped_actions.put_nowait(
                            (device_name, action_name)
                        )
                    except queue.Full:
                        pass

        except Exception as e:
            self.logger.error(f"Error processing message: {e}")

    def _process_button_event(self, device_name: str, data: Dict[str, Any]) -> None:
        """Route only a configured device and explicitly mapped action.

        Receives MQTT messages on its worker thread. UI and audio work are
        handed to the application via the existing hardware event queue.
        """
        try:
            action = next((data[k] for k in ("action", "click", "state")
                           if k in data), None)
            if action is None or isinstance(action, (dict, list)):
                return
            action_name = str(action).strip().lower()
            if not action_name:
                return

            self.logger.info("Button action from %s: %s", device_name, action)
            if self.gui_log_callback:
                self.gui_log_callback(
                    f"Button '{device_name}' action '{action}' received via Zigbee/MQTT."
                )

            # Use the first (unique) saved row for this exact button and action.
            mapping = next((row for row in self.config.get("action_mappings", [])
                            if row["device"] == device_name
                            and row["action"] == action_name), None)
            if mapping is None:
                if self.gui_log_callback:
                    self.gui_log_callback(
                        f"Unmapped action: {device_name} / {action_name}; "
                        "ignored (use Auto-add From Log to configure)."
                    )
                try:
                    self.unmapped_actions.put_nowait((device_name, action_name))
                except queue.Full:
                    # Never delay or block MQTT processing to update a UI table.
                    pass
                return

            action_id = mapping["uwh_action"]
            if action_id == "ignore":
                if self.gui_log_callback:
                    self.gui_log_callback(
                        f"Button '{device_name}' action '{action_name}' "
                        "is mapped to Ignore; no siren played."
                    )
                return
            if action_id in ACTION_TO_EVENT:
                self._trigger_siren(ACTION_TO_EVENT[action_id])
            elif action_id == "start_continuous":
                self._trigger_siren(f"WIRELESS_PRESS:{device_name}")
            elif action_id == "stop_continuous":
                self._trigger_siren(f"WIRELESS_RELEASE:{device_name}")
        except Exception as e:
            self.logger.error("Error processing button event: %s", e)

    def consume_unmapped_actions(self):
        """Return first-seen unmapped events for the UI's Auto-add action."""
        items = []
        seen = set()
        while True:
            try:
                pair = self.unmapped_actions.get_nowait()
            except queue.Empty:
                return items
            if pair not in seen:
                items.append(pair)
                seen.add(pair)

    def _trigger_siren(self, event_name="ON") -> None:
        """Ordered handoff; the UWH callback only puts into a thread-safe queue."""
        self.logger.info("Triggering wireless siren event: %s", event_name)
        if self.siren_callback:
            try:
                self.siren_callback(event_name)
            except Exception as e:
                self.logger.error("Error queuing siren event: %s", e)
        else:
            self.logger.warning("No siren callback set")

    def test_siren(self) -> None:
        self.logger.info("Manual MQTT siren test triggered")

        if self.gui_log_callback:
            self.gui_log_callback("Manual MQTT siren test triggered")

        self.start_siren_continuous()

    def stop_test_siren(self) -> None:
        self.logger.info("Manual MQTT siren test stopping")

        if self.gui_log_callback:
            self.gui_log_callback("Manual MQTT siren test stopping")

        self.stop_siren_continuous()

    def handle_hardware_siren_event(self, event_name: str) -> None:
        """Forward an Arduino press/release to the MQTT-controlled siren.

        The controller owns the siren device; UWH owns local PC audio.
        This method must be part of the controller class, not module-level.
        """
        if event_name == "ON":
            self.start_siren_continuous()
        elif event_name == "OFF":
            self.stop_siren_continuous()

    def start_siren_continuous(self, sound_config: Dict[str, Any] = None) -> None:
        self.logger.info("Starting continuous siren playback")
        self.start_siren()

    def stop_siren_continuous(self) -> None:
        self.logger.info("Stopping continuous siren playback")
        self.stop_siren()

    def start_siren(self) -> bool:
        """Publish ON to the optional MQTT siren OUTPUT, not the input button.
        """
        if not MQTT_AVAILABLE:
            self.logger.warning("MQTT not available - cannot control siren")
            return False

        if not self.connected or not self.mqtt_client:
            self.logger.warning("MQTT not connected - cannot start siren")
            return False

        try:
            siren_device = self.config.get("siren_device_name", "zigbee_siren")
            topic = f"zigbee2mqtt/{siren_device}/set"
            payload = json.dumps({"state": "ON"})

            self.logger.info(
                f"Starting siren: Publishing to {topic} with payload {payload}"
            )

            result = self.mqtt_client.publish(topic, payload)

            try:
                result.wait_for_publish(timeout=2)
            except TypeError:
                result.wait_for_publish()

            return True

        except Exception as e:
            self.logger.error(f"Error starting siren: {e}")
            return False

    def stop_siren(self) -> bool:
        """Publish OFF to the optional MQTT siren OUTPUT.
        """
        if not MQTT_AVAILABLE:
            self.logger.warning("MQTT not available - cannot control siren")
            return False

        if not self.connected or not self.mqtt_client:
            self.logger.warning("MQTT not connected - cannot stop siren")
            return False

        try:
            siren_device = self.config.get("siren_device_name", "zigbee_siren")
            topic = f"zigbee2mqtt/{siren_device}/set"
            payload = json.dumps({"state": "OFF"})

            self.logger.info(
                f"Stopping siren: Publishing to {topic} with payload {payload}"
            )

            result = self.mqtt_client.publish(topic, payload)

            try:
                result.wait_for_publish(timeout=2)
            except TypeError:
                result.wait_for_publish()

            return True

        except Exception as e:
            self.logger.error(f"Error stopping siren: {e}")
            return False

    def _notify_status(self, connected: bool, message: str) -> None:
        if self.connection_status_callback:
            try:
                self.connection_status_callback(connected, message)
            except Exception as e:
                self.logger.error(f"Error calling status callback: {e}")

    def get_status(self) -> Dict[str, Any]:
        devices = list(self.config.get("siren_button_devices", []))
        legacy_device = self.config.get("siren_button_device", "")

        if legacy_device and legacy_device not in devices:
            devices.append(legacy_device)

        return {
            "connected": self.connected,
            "mqtt_available": MQTT_AVAILABLE,
            "broker": f"{self.config.get('mqtt_broker', 'localhost')}:{self.config.get('mqtt_port', 1883)}",
            "topic": self.config.get("mqtt_topic", "zigbee2mqtt/+"),
            "devices": devices,
            "device": legacy_device,
            "zigbee_port": self.config.get("serial_port", ""),
        }

    def test_connection(self) -> bool:
        """Probe connectivity without replacing the controller's live session.
        """
        if not MQTT_AVAILABLE:
            return False

        try:
            test_client = mqtt.Client()

            if self.config.get("mqtt_username"):
                test_client.username_pw_set(
                    self.config.get("mqtt_username", ""),
                    self.config.get("mqtt_password", "")
                )

            test_client.connect(
                self.config.get("mqtt_broker", "localhost"),
                int(self.config.get("mqtt_port", 1883)),
                10
            )
            test_client.disconnect()
            return True

        except Exception as e:
            self.logger.error(f"Connection test failed: {e}")
            return False


def get_default_config() -> Dict[str, Any]:
    config = DEFAULT_CONFIG.copy()
    config["serial_port"] = get_zigbee_port_from_lead_detector()
    return config


def is_mqtt_available() -> bool:
    return MQTT_AVAILABLE


def is_pyserial_available() -> bool:
    return PYSERIAL_AVAILABLE


def get_platform_info() -> Dict[str, Any]:
    return {
        "platform": CURRENT_PLATFORM,
        "is_windows": IS_WINDOWS,
        "is_linux": IS_LINUX,
        "mqtt_available": MQTT_AVAILABLE,
        "pyserial_available": PYSERIAL_AVAILABLE,
    }


def create_controller(
    siren_callback: Optional[Callable] = None,
    gui_log_callback: Optional[Callable[[str], None]] = None
):
    logger = logging.getLogger(__name__)
    logger.info(f"Running on {CURRENT_PLATFORM} - using standard MQTT controller")

    return ZigbeeSirenController(
        siren_callback=siren_callback,
        gui_log_callback=gui_log_callback
    )
