davidstirling777-star/Underwater-Hockey-Scoring-Desk-Kit/game_engine.py

"""Game state, period sequencing and timer/penalty policy.

GameEngine stores mutable match state but does not own Tk widgets or disk
writes. uwh.py drives the Tk after() clock and delegates transitions and
export safety to game_flow.py. Period names are shared with that UI.
"""

class GameEngine:
    """In-memory match rules/state; uwh.py owns Tk and disk I/O."""
    def __init__(self):
        self.white_goal_scorers = {}
        self.black_goal_scorers = {}

        self.stored_penalties = []
        self.active_penalties = []

        self.white_timeouts_this_half = 0
        self.black_timeouts_this_half = 0
        self.active_timeout_team = None

        self.sudden_death_goal_scored = False
        self.sudden_death_restore_time = None
        self.sudden_death_restore_active = False
        self.sudden_death_seconds = 0

        self.saved_state = {}

        self.full_sequence = []
        self.current_index = 0

        self.timer_running = True
        self.timer_seconds = 0

        self.saved_timer_running = False
        self.saved_timer_seconds = 0

    # ------------------------------------------------------------------
    # Goal scorers
    # ------------------------------------------------------------------

    def record_goal_scorer(self, team, cap_number):
        """Count a confirmed goal by cap; None means scorer recording was skipped.
        """
        if cap_number is None:
            return

        if team == "White":
            self.white_goal_scorers[cap_number] = (
                self.white_goal_scorers.get(cap_number, 0) + 1
            )

        elif team == "Black":
            self.black_goal_scorers[cap_number] = (
                self.black_goal_scorers.get(cap_number, 0) + 1
            )

    def clear_goal_scorers(self):
        """Reset scorer counts only after the previous game was safely exported.
        """
        self.white_goal_scorers.clear()
        self.black_goal_scorers.clear()

    # ------------------------------------------------------------------
    # Penalties
    # ------------------------------------------------------------------

    def clear_penalties(self):
        self.stored_penalties.clear()
        self.active_penalties.clear()

    # ------------------------------------------------------------------
    # Timeouts
    # ------------------------------------------------------------------

    def reset_timeouts(self):
        self.white_timeouts_this_half = 0
        self.black_timeouts_this_half = 0
        self.active_timeout_team = None

    def reset_half_timeouts(self):
        self.white_timeouts_this_half = 0
        self.black_timeouts_this_half = 0

    def start_timeout(self, team):
        """Mark a team timeout in progress and consume this half's allowance.
        """
        if team == "White":
            self.active_timeout_team = "white"
            self.white_timeouts_this_half += 1

        elif team == "Black":
            self.active_timeout_team = "black"
            self.black_timeouts_this_half += 1

    def end_timeout(self):
        self.active_timeout_team = None

    # ------------------------------------------------------------------
    # Sudden death
    # ------------------------------------------------------------------

    def mark_sudden_death_goal(self, remaining_time):
        """Remember when Sudden Death ended so a correction can restore it.
        """
        self.sudden_death_restore_time = remaining_time
        self.sudden_death_restore_active = True
        self.sudden_death_goal_scored = True

    def clear_sudden_death_goal(self):
        self.sudden_death_restore_time = None
        self.sudden_death_restore_active = False
        self.sudden_death_goal_scored = False
        self.sudden_death_seconds = 0

    # ------------------------------------------------------------------
    # Period sequence
    # ------------------------------------------------------------------

    def set_sequence(self, sequence):
        self.full_sequence = sequence
        self.current_index = 0

    def get_current_period(self):
        if not self.full_sequence:
            return None

        if self.current_index >= len(self.full_sequence):
            return None

        return self.full_sequence[self.current_index]

    def get_previous_period(self):
        if self.current_index <= 0:
            return None

        return self.full_sequence[self.current_index - 1]

    def get_first_period(self):
        if not self.full_sequence:
            return None

        return self.full_sequence[0]

    def find_period_index(self, name):
        for idx, period in enumerate(self.full_sequence):
            if period["name"] == name:
                return idx

        return len(self.full_sequence) - 1

    def set_current_period(self, index):
        self.current_index = index

    def next_period_index(self):
        self.current_index += 1

    def reset_to_first_half(self):
        self.current_index = self.find_period_index("First Half")

    def reset_to_between_game_break(self):
        self.current_index = self.find_period_index(
            "Between Game Break"
        )

    def reset_to_first_period(self):
        self.current_index = 0

    def go_to_period(self, period_name):
        self.current_index = self.find_period_index(period_name)

    def advance_period(self, white_score, black_score):
        """Choose the next period, skipping overtime when a team leads.
        The end-of-game export is gated by game_flow, not this state method.
        """
        if self.current_index >= len(self.full_sequence):
            self.reset_to_between_game_break()
            return True

        cur_period = self.full_sequence[self.current_index]
        period_name = cur_period["name"]

        if period_name == "Second Half" and white_score != black_score:
            self.reset_to_between_game_break()
            return True

        if period_name == "Overtime Second Half" and white_score != black_score:
            self.reset_to_between_game_break()
            return True

        if period_name == "Sudden Death" and self.sudden_death_goal_scored:
            self.reset_to_between_game_break()
            return True

        self.current_index += 1

        if self.current_index >= len(self.full_sequence):
            self.reset_to_first_half()

        return True

    # ------------------------------------------------------------------
    # Timer state
    # ------------------------------------------------------------------

    def start_timer(self):
        self.timer_running = True

    def stop_timer(self):
        self.timer_running = False

    def set_timer_seconds(self, seconds):
        self.timer_seconds = seconds

    def decrement_timer(self):
        if self.timer_seconds > 0:
            self.timer_seconds -= 1

    def save_timer_state(self, timer_running, timer_seconds):
        self.saved_timer_running = timer_running
        self.saved_timer_seconds = timer_seconds

    def restore_timer_state(self):
        return (
            self.saved_timer_running,
            self.saved_timer_seconds
        )

    def clear_timer_state(self):
        self.saved_timer_running = False
        self.saved_timer_seconds = 0

    # ------------------------------------------------------------------
    # Period event names
    # ------------------------------------------------------------------

    def period_start_event_name(self, period_name):
        start_events = {
            "First Half": "First Half Start",
            "Second Half": "Second Half Start",
            "Overtime First Half": "Overtime First Half Start",
            "Overtime Second Half": "Overtime Second Half Start",
            "Sudden Death": "Sudden Death Start",
        }

        return start_events.get(period_name)

    def period_end_event_name(self, period_name):
        end_events = {
            "First Half": "First Half End",
            "Second Half": "Second Half End",
            "Overtime First Half": "Overtime First Half End",
            "Overtime Second Half": "Overtime Second Half End",
            "Sudden Death": "Sudden Death End",
        }

        return end_events.get(period_name)

    # ------------------------------------------------------------------
    # Period rules / classifications
    # ------------------------------------------------------------------

    def timeouts_disabled_periods(self):
        return [
            "First Game Starts In:",
            "Half Time",
            "Overtime Game Break",
            "Sudden Death Game Break",
            "Overtime First Half",
            "Overtime Half Time",
            "Overtime Second Half",
            "Sudden Death",
        ]

    def penalty_disabled_periods(self):
        return [
            "First Game Starts In:",
            "Between Game Break",
            "Half Time",
            "Overtime Game Break",
            "Overtime Half Time",
            "Sudden Death Game Break",
        ]

    def penalty_pause_periods(self):
        return [
            "First Game Starts In:",
            "Between Game Break",
            "Half Time",
            "Overtime Game Break",
            "Overtime Half Time",
            "Sudden Death Game Break",
            "White Team Time-Out",
            "Black Team Time-Out",
            "Referee Time-Out",
        ]

    def court_time_paused_periods(self):
        return [
            "Overtime Game Break",
            "Overtime First Half",
            "Overtime Half Time",
            "Overtime Second Half",
            "Sudden Death Game Break",
            "Sudden Death",
            "White Team Time-Out",
            "Black Team Time-Out",
            "Referee Time-Out",
        ]

    def is_sudden_death(self, period_name):
        return period_name == "Sudden Death"
    
    
    def is_between_game_break(self, period_name):
        return period_name == "Between Game Break"
    
    
    def is_referee_timeout(self, period_name):
        return period_name == "Referee Time-Out"
    
    
    def is_timeout_disabled_period(self, period_name):
        return period_name in self.timeouts_disabled_periods()
    
    
    def is_penalty_disabled_period(self, period_name):
        return period_name in self.penalty_disabled_periods()
    
    
    def is_penalty_pause_period(self, period_name):
        return period_name in self.penalty_pause_periods()
    
    
    def is_court_time_paused_period(self, period_name):
        return period_name in self.court_time_paused_periods()

    def is_regular_timeout_reset_period(self, period_name):
        return period_name in [
            "First Half",
            "Second Half",
            "Between Game Break"
        ]
    def format_seconds_as_mmss(self, seconds):
        mins, secs = divmod(max(0, int(seconds)), 60)
        return f"{mins:02d}:{secs:02d}"

    def should_play_period_end_siren(self, period):
        """Report whether the tick about to reach 00:00 needs a siren.
        """
        if not period:
            return False

        if self.timer_seconds != 1:
            return False

        break_periods = [
            "First Game Starts In:",
            "Between Game Break",
            "Half Time",
            "Sudden Death Game Break",
            "Overtime Game Break",
            "Overtime Half Time",
        ]

        half_periods = [
            "First Half",
            "Second Half",
            "Overtime First Half",
            "Overtime Second Half",
        ]

        if period["type"] == "break" and period["name"] in break_periods:
            return True

        if period["type"] in ["regular", "overtime"] and period["name"] in half_periods:
            return True

        return False

    def should_play_break_countdown_pip(self, period):
        """Trigger the 30-second pip at 31, then pips at 11 through 2.
        The actual timer display decrements immediately after the cue.
        """
        if not period:
            return False

        if period["type"] != "break":
            return False

        break_periods = [
            "First Game Starts In:",
            "Between Game Break",
            "Half Time",
            "Sudden Death Game Break",
            "Overtime Game Break",
            "Overtime Half Time",
        ]

        if period["name"] not in break_periods:
            return False

        if self.timer_seconds == 31:
            return True

        if 2 <= self.timer_seconds <= 11:
            return True

        return False

    def should_export_game_results(self, period):
        """
        Kept as a compatibility hook.

        UWH handles the export within countdown_timer just before its
        30-second Between Game Break warning pip, rather than scheduling
        an independent job when the break starts.
        """
        return False
