davidstirling777-star/Underwater-Hockey-Scoring-Desk-Kit/app_version.py

"""Small, user-visible UWH application version identifier.

Source installations identify this restored classic-UI branch below. The
release workflow calculates the next available numeric v1.2 patch release,
then stamps that same version into both Windows and Raspberry Pi 5 packages.
"""

APP_VERSION = "1.2.source.classic"
