davidstirling777-star/Underwater-Hockey-Scoring-Desk-Kit/display_manager.py

"""Small penalty-label helpers shared by operator and presentation screens.

The Tk widget lifecycle lives in display_ui.py and uwh.py. Keep formatting
here independent of which physical monitor receives the scoreboard.
"""

def penalty_sort_key(p):
    return (
        p["seconds_remaining"]
        if not p["is_rest_of_match"]
        else 999999
    )


def format_penalty_label(p):
    """Return the penalty text shown on operator and display screens."""
    cap_str = f"#{p['cap']}"

    if p["is_rest_of_match"]:
        # CMAS terminology for a penalty lasting for the remainder
        # of the match. The line break keeps the text readable in
        # the narrow penalty cells used on the display windows.
        return f"{cap_str}  TOTAL DISMISSAL"

    mins, secs = divmod(
        p["seconds_remaining"],
        60
    )
    time_str = f"{mins}:{secs:02d}"

    return f"{cap_str}  {time_str}"
