davidstirling777-star/Underwater-Hockey-Scoring-Desk-Kit/settings_ui.py

"""Build the Game Variables, Tournament List, About and Screens control tabs.

The widgets write into GameManagementApp/engine state, not directly into
settings.json. Automatic edits are queued for a coalesced save; buttons that
explicitly say Save may use their own immediate persistence path.
"""


import tkinter as tk
from tkinter import ttk, font, messagebox
from pathlib import Path
import re
import webbrowser

from app_version import APP_VERSION

def create_settings_tab(app):
    """Create the Game Variables, presets and Game Sequence widgets."""
    tab = ttk.Frame(app.notebook)
    app.notebook.add(tab, text="Game Variables")

    # Keep enough height for the expanded Tournament List controls while
    # returning useful vertical space to the full Game Sequence explanation.
    tab.grid_rowconfigure(0, weight=2)
    tab.grid_rowconfigure(1, weight=0)
    tab.grid_rowconfigure(2, weight=2)
    tab.grid_rowconfigure(3, weight=1)
    tab.grid_columnconfigure(0, weight=2)
    tab.grid_columnconfigure(1, weight=1)

    default_font = font.nametofont("TkDefaultFont")
    new_size = default_font.cget("size") + 2
    small_size = default_font.cget("size") - 1
    headers = ["Use?", "Variable", "Value", "Units"]

    style = ttk.Style()
    style.configure(
        "Large.TCheckbutton",
        focuscolor="none",
        font=(default_font.cget("family"), default_font.cget("size") + 2)
    )

    # ------------------------------------------------------------
    # Widget 1 - Game Variables
    # ------------------------------------------------------------
    widget1 = ttk.Frame(tab, borderwidth=1, relief="solid")
    widget1.grid(row=0, column=0, rowspan=4, sticky="nsew", padx=8, pady=8)

    for i in range(4):
        widget1.grid_columnconfigure(i, weight=1)

    for i in range(17):
        widget1.grid_rowconfigure(i, weight=1)

    for i, h in enumerate(headers):
        tk.Label(
            widget1,
            text=h,
            font=(default_font.cget("family"), new_size, "bold")
        ).grid(row=0, column=i, sticky="w", padx=5, pady=4)

    row_idx = 1
    app.widgets = []

    entry_order = list(app.variables.keys())

    for special_name in [
        "time_to_start_first_game",
        "start_first_game_in",
        "team_timeouts_allowed",
        "overtime_allowed",
        "record_scorers_cap_number"
    ]:
        if special_name in entry_order:
            entry_order.remove(special_name)

    crib_time_index = (
        entry_order.index("crib_time")
        if "crib_time" in entry_order
        else len(entry_order)
    )

    entry_order = (
        ["time_to_start_first_game", "start_first_game_in"]
        + entry_order[:crib_time_index]
        + ["record_scorers_cap_number"]
        + entry_order[crib_time_index:]
    )

    for var_name in entry_order:
        var_info = app.variables[var_name]

        if (
            var_info["checkbox"]
            and var_name in [
                "team_timeouts_allowed",
                "overtime_allowed",
                "record_scorers_cap_number"
            ]
        ):
            var_info["default"] = var_info.get("default", True)

        if var_name == "record_scorers_cap_number":
            check_var = app.record_scorers_cap_number_var
            cb = ttk.Checkbutton(
                widget1,
                variable=check_var,
                style="Large.TCheckbutton"
            )
            cb.grid(row=row_idx, column=0, sticky="", pady=5, padx=(10, 0))

            label_widget = tk.Label(
                widget1,
                text=var_info.get("label", "Record Scorers Cap Number"),
                font=(default_font.cget("family"), new_size, "bold")
            )
            label_widget.grid(row=row_idx, column=1, sticky="w", pady=4)

            check_var.trace_add(
                "write",
                lambda *args: app._on_single_variable_change(
                    "record_scorers_cap_number"
                )
            )

            app.widgets.append({
                "name": var_name,
                "entry": None,
                "checkbox": check_var,
                "label_widget": label_widget
            })

            row_idx += 1
            continue

        if var_name == "team_timeout_period":
            # Keep team_timeouts_allowed as its own saved setting, but place
            # its checkbox beside Team Time-Out Period rather than on a
            # separate row.
            check_var = app.team_timeouts_allowed_var
            cb = ttk.Checkbutton(
                widget1,
                variable=check_var,
                style="Large.TCheckbutton"
            )
            cb.grid(row=row_idx, column=0, sticky="", pady=5, padx=(10, 0))
            check_var.trace_add(
                "write",
                lambda *args: app._on_team_timeouts_change()
            )
        elif var_name == "overtime_game_break":
            # Keep the existing overtime_allowed setting, but place its
            # checkbox beside Overtime Game Break rather than on its own row.
            check_var = app.overtime_allowed_var
            cb = ttk.Checkbutton(
                widget1,
                variable=check_var,
                style="Large.TCheckbutton"
            )
            cb.grid(row=row_idx, column=0, sticky="", pady=5, padx=(10, 0))
            check_var.trace_add(
                "write",
                lambda *args: app._on_overtime_change()
            )
        else:
            check_var = (
                tk.BooleanVar(value=True)
                if var_info["checkbox"]
                else None
            )

            if check_var:
                cb = ttk.Checkbutton(
                    widget1,
                    variable=check_var,
                    style="Large.TCheckbutton"
                )
                cb.grid(row=row_idx, column=0, sticky="", pady=5, padx=(10, 0))
                check_var.trace_add(
                    "write",
                    lambda *args, name=var_name:
                        app._on_single_variable_change(name)
                )

        label_text = var_info.get(
            "label",
            f"{var_name.replace('_', ' ').title()}:"
        )

        label_widget = tk.Label(
            widget1,
            text=label_text,
            font=(default_font.cget("family"), new_size, "bold")
        )
        label_widget.grid(row=row_idx, column=1, sticky="w", pady=4)

        entry = ttk.Entry(widget1, width=10)

        if var_name == "time_to_start_first_game":
            entry.insert(0, "")

            def validate_hhmm_on_focusout(event):
                val = event.widget.get().strip()

                if val == "":
                    return

                if not re.fullmatch(
                    r"(?:[01]?[0-9]|2[0-3]):[0-5][0-9]",
                    val
                ):
                    messagebox.showerror(
                        "Input Error",
                        "Please enter a 24-hour time as H:MM or HH:MM "
                        "(e.g., 9:36 or 09:36)."
                    )
                    event.widget.focus_set()
                    event.widget.selection_range(0, tk.END)
                    return

                app._on_single_variable_change("time_to_start_first_game")

            entry.bind("<FocusOut>", validate_hhmm_on_focusout)
            entry.bind("<Return>", validate_hhmm_on_focusout)

        else:
            entry.insert(0, "1")

            if var_name in ["crib_time", "sudden_death_game_break"]:

                def validate_numeric_on_focusout(event, field_name=var_name):
                    val = event.widget.get().strip()

                    if val == "":
                        return

                    try:
                        val_normalized = val.replace(",", ".")
                        val_float = float(val_normalized)

                        if field_name == "crib_time":
                            between_game_break_minutes = None

                            for widget in app.widgets:
                                if widget["name"] == "between_game_break":
                                    try:
                                        bgb_val = (
                                            widget["entry"]
                                            .get()
                                            .strip()
                                            .replace(",", ".")
                                        )
                                        between_game_break_minutes = float(bgb_val)
                                    except (ValueError, AttributeError):
                                        pass
                                    break

                            if between_game_break_minutes is not None:
                                crib_time_seconds = val_float

                                if (
                                    between_game_break_minutes * 60
                                ) - crib_time_seconds <= 31:
                                    messagebox.showerror(
                                        "Input Error",
                                        "Crib time too large. Between Game "
                                        "Break minus Crib time must be > "
                                        "31 seconds."
                                    )
                                    event.widget.delete(0, tk.END)
                                    event.widget.insert(
                                        0,
                                        app.last_valid_values[field_name]
                                    )
                                    event.widget.focus_set()
                                    event.widget.selection_range(0, tk.END)
                                    return

                        app.last_valid_values[field_name] = val
                        app._on_single_variable_change(field_name)

                    except ValueError:
                        messagebox.showerror(
                            "Input Error",
                            f"Please enter a valid number for "
                            f"{field_name.replace('_', ' ').title()}."
                        )
                        event.widget.delete(0, tk.END)
                        event.widget.insert(
                            0,
                            app.last_valid_values[field_name]
                        )
                        event.widget.focus_set()
                        event.widget.selection_range(0, tk.END)

                entry.bind("<FocusOut>", validate_numeric_on_focusout)
                entry.bind("<Return>", validate_numeric_on_focusout)

            else:
                entry.bind(
                    "<FocusOut>",
                    lambda e, name=var_name: app._on_single_variable_change(name)
                )
                entry.bind(
                    "<Return>",
                    lambda e, name=var_name: app._on_single_variable_change(name)
                )

        entry.grid(row=row_idx, column=2, sticky="w", padx=5, pady=4)

        tk.Label(
            widget1,
            text=var_info["unit"],
            font=(default_font.cget("family"), new_size, "bold")
        ).grid(row=row_idx, column=3, sticky="w", padx=5, pady=4)

        if var_name == "team_timeout_period":
            # Store the enable flag separately from the duration even though
            # both controls now share one visible row.
            app.widgets.append({
                "name": "team_timeouts_allowed",
                "entry": None,
                "checkbox": app.team_timeouts_allowed_var,
                "label_widget": None
            })
            app.widgets.append({
                "name": var_name,
                "entry": entry,
                "checkbox": None,
                "label_widget": label_widget
            })
        elif var_name == "overtime_game_break":
            # Store the enable flag and numeric duration as the same two
            # runtime/settings variables used by the classic application.
            app.widgets.append({
                "name": "overtime_allowed",
                "entry": None,
                "checkbox": app.overtime_allowed_var,
                "label_widget": None
            })
            app.widgets.append({
                "name": var_name,
                "entry": entry,
                "checkbox": None,
                "label_widget": label_widget
            })
        else:
            app.widgets.append({
                "name": var_name,
                "entry": entry,
                "checkbox": check_var,
                "label_widget": label_widget
            })

        app.last_valid_values[var_name] = entry.get()

        if var_name == "team_timeout_period":
            app.team_timeout_period_entry = entry
            app.team_timeout_period_label = label_widget

        row_idx += 1

        if var_name == "crib_time":
            combined_explanation = tk.Label(
                widget1,
                text=(
                    "• Crib Time is a period (in seconds) that is "
                    "subtracted from the \"Between Game Break\" time at "
                    "the start of each game\n"
                    "to try to realign Court Time with Local Computer Time.\n"
                    "• Value boxes accept decimal time e.g. 1.5 or 1,5 = "
                    "1 min, 30 sec"
                ),
                font=(default_font.cget("family"), small_size),
                anchor="w",
                justify="left",
                wraplength=600
            )
            combined_explanation.grid(
                row=row_idx,
                column=0,
                columnspan=4,
                pady=3,
                sticky="nsew"
            )

            row_idx += 1

            reset_warning_bullet = tk.Label(
                widget1,
                text=(
                    "• If you change any value in here, push the "
                    "'Reset Timer' Button!"
                ),
                font=(default_font.cget("family"), small_size, "bold"),
                fg="red",
                anchor="w",
                justify="left",
                wraplength=600
            )
            reset_warning_bullet.grid(
                row=row_idx,
                column=0,
                columnspan=4,
                pady=3,
                sticky="nsew"
            )

            row_idx += 1

    app.reset_timer_button = ttk.Button(
        widget1,
        text="Reset Timer",
        command=app.reset_timer
    )
    app.reset_timer_button.grid(
        row=row_idx,
        column=0,
        columnspan=4,
        pady=8
    )

    # Keep a small version identifier permanently visible in the lower-right
    # corner of the Game Variables ("Use?") panel. This is deliberately
    # unobtrusive but makes it easy to confirm which downloaded build is open.
    widget1.grid_rowconfigure(row_idx + 1, weight=0)
    tk.Label(
        widget1,
        text=f"UWH v{APP_VERSION}",
        font=(default_font.cget("family"), small_size),
        fg="gray"
    ).grid(
        row=row_idx + 1,
        column=3,
        sticky="se",
        padx=6,
        pady=(0, 4)
    )

    # ------------------------------------------------------------
    # Widget 2 - Presets
    # ------------------------------------------------------------
    widget2 = ttk.Frame(tab, borderwidth=1, relief="solid")
    widget2.grid(row=0, column=1, sticky="nsew", padx=4, pady=4)

    for col in range(3):
        widget2.grid_columnconfigure(col, weight=1)

    widget2.grid_rowconfigure(0, weight=0)
    widget2.grid_rowconfigure(1, weight=0, minsize=38)
    widget2.grid_rowconfigure(2, weight=0, minsize=38)
    widget2.grid_rowconfigure(3, weight=0, minsize=38)
    widget2.grid_rowconfigure(4, weight=1)
    widget2.grid_rowconfigure(5, weight=0)

    header_label = tk.Label(
        widget2,
        text="Presets",
        font=(default_font.cget("family"), new_size, "bold")
    )
    header_label.grid(
        row=0,
        column=0,
        columnspan=3,
        padx=4,
        pady=(8, 4),
        sticky="nsew"
    )

    app.widget2_buttons = []
    preset_data = app.load_preset_settings()
    app.button_data = preset_data.copy()

    for i in range(9):
        btn_row = 1 + (i // 3)
        btn_col = i % 3

        btn = tk.Button(
            widget2,
            text=app.button_data[i]["text"],
            font=(
                default_font.cget("family"),
                default_font.cget("size") + 1,
                "bold"
            ),
            width=12,
            height=1,
            relief="raised",
            borderwidth=2
        )

        btn.grid(
            row=btn_row,
            column=btn_col,
            padx=8,
            pady=4,
            sticky="nsew"
        )

        btn.bind("<ButtonPress-1>", app._make_press_handler(i))
        btn.bind("<ButtonRelease-1>", app._make_release_handler(i))

        app.widget2_buttons.append(btn)

    instruction1 = tk.Label(
        widget2,
        text="Click the buttons above to load preset times and allowed Game Periods",
        anchor="w",
        justify="left",
        font=(default_font.cget("family"), default_font.cget("size"))
    )
    instruction1.grid(
        row=4,
        column=0,
        columnspan=3,
        sticky="w",
        padx=8,
        pady=(4, 1)
    )

    instruction2 = tk.Label(
        widget2,
        text="Press and hold a preset for 3 seconds to edit its stored values",
        anchor="w",
        justify="left",
        font=(default_font.cget("family"), default_font.cget("size"))
    )
    instruction2.grid(
        row=5,
        column=0,
        columnspan=3,
        sticky="w",
        padx=8,
        pady=(1, 6)
    )

    # ------------------------------------------------------------
    # Widget 3 - Game Sequence
    # ------------------------------------------------------------
    widget3 = ttk.Frame(tab, borderwidth=1, relief="solid")
    widget3.grid(
        row=2,
        column=1,
        rowspan=2,
        sticky="nsew",
        padx=8,
        pady=8
    )

    widget3.grid_columnconfigure(0, weight=1)
    widget3.grid_rowconfigure(0, weight=0)
    widget3.grid_rowconfigure(1, weight=1)
    widget3.grid_rowconfigure(2, weight=0)

    explanation_header = tk.Label(
        widget3,
        text="Game Sequence",
        font=(default_font.cget("family"), new_size, "bold")
    )
    explanation_header.grid(
        row=0,
        column=0,
        padx=4,
        pady=(8, 2),
        sticky="ew"
    )

    explanation_text = (
        "Game Sequence Flow:\n"
        "1. First Game Starts In: (runs once at app start)\n"
        "2. First Half → Half Time → Second Half\n"
        "3. If scores tied: Overtime Game Break → Overtime First Half "
        "→ Overtime Half Time → Overtime Second Half (if enabled)\n"
        "4. If still tied: Sudden Death Game Break → Sudden Death (if enabled)\n"
        "5. Between Game Break (loop back to step 2)\n\n"
        "Important Notes:\n"
        "• 'First Game Starts In:' transitions directly to First Half\n"
        "• Crib time is subtracted from Between Game Break"
    )

    explanation_label = tk.Label(
        widget3,
        text=explanation_text,
        font=(default_font.cget("family"), small_size),
        justify="left",
        anchor="nw"
    )
    explanation_label.grid(
        row=1,
        column=0,
        padx=4,
        pady=(2, 4),
        sticky="nsew"
    )

    # Exit control is deliberately kept on the Game Variables tab,
    # away from the normal match controls.
    exit_frame = ttk.Frame(widget3)
    exit_frame.grid(
        row=2,
        column=0,
        sticky="e",
        padx=8,
        pady=(2, 8)
    )

    app.exit_program_button = tk.Button(
        exit_frame,
        text="Exit Program",
        bg="red",
        fg="white",
        activebackground="darkred",
        activeforeground="white",
        command=app.request_exit,
        width=14
    )
    app.exit_program_button.pack()

    app.update_overtime_variables_state()


def create_tournament_tab(app):
    """Create the standalone Tournament List and results-sync tab."""
    tab = ttk.Frame(app.notebook)
    app.tournament_tab = tab
    app.notebook.add(tab, text="Tournament List")

    tab.grid_rowconfigure(0, weight=1)
    tab.grid_columnconfigure(0, weight=1)

    default_font = font.nametofont("TkDefaultFont")
    new_size = default_font.cget("size") + 2
    small_size = default_font.cget("size") - 1

    # ------------------------------------------------------------
    # Tournament List controls
    # ------------------------------------------------------------
    widget4 = ttk.Frame(tab, borderwidth=1, relief="solid")
    widget4.grid(row=0, column=0, sticky="nsew", padx=12, pady=12)

    widget4.grid_columnconfigure(0, weight=0)
    widget4.grid_columnconfigure(1, weight=1)
    widget4.grid_columnconfigure(2, weight=0)
    widget4.grid_columnconfigure(3, weight=0, minsize=55)
    widget4.grid_columnconfigure(4, weight=0)

    widget4.grid_rowconfigure(0, weight=0)
    widget4.grid_rowconfigure(1, weight=0)
    widget4.grid_rowconfigure(2, weight=0)
    widget4.grid_rowconfigure(3, weight=0)
    widget4.grid_rowconfigure(4, weight=0)
    widget4.grid_rowconfigure(8, weight=0)

    tournament_header = tk.Label(
        widget4,
        text="Tournament List",
        font=(default_font.cget("family"), new_size, "bold")
    )
    tournament_header.grid(
        row=0,
        column=0,
        columnspan=5,
        padx=8,
        pady=(10, 8),
        sticky="ew"
    )

    # ------------------------------------------------------------
    # Tournament-list enable/disable control
    # ------------------------------------------------------------
    #
    # This deliberately defaults to True each time the application
    # starts. The checkbox controls whether tournament team names are
    # used, but does not prevent the CSV folder from being opened.
    app.use_tournament_list_var = tk.BooleanVar(
        master=app.master,
        value=True
    )

    use_tournament_list_checkbox = ttk.Checkbutton(
        widget4,
        text="Use Tournament List?",
        variable=app.use_tournament_list_var,
        command=app.on_use_tournament_list_changed
    )
    use_tournament_list_checkbox.grid(
        row=1,
        column=0,
        sticky="w",
        padx=(8, 4),
        pady=2
    )

    # ------------------------------------------------------------
    # Tournament-draw CSV dropdown
    # ------------------------------------------------------------
    csv_files = app.get_csv_files()

    app.csv_var = tk.StringVar(
        master=app.master,
        value=(
            csv_files[0]
            if csv_files
            else "No CSV files found"
        )
    )

    app.csv_dropdown = ttk.Combobox(
        widget4,
        textvariable=app.csv_var,
        values=csv_files,
        state="readonly",
        width=16,
        postcommand=app.refresh_csv_dropdown
    )
    app.csv_dropdown.grid(
        row=1,
        column=1,
        columnspan=3,
        sticky="ew",
        padx=(4, 4),
        pady=2
    )
    app.csv_dropdown.bind(
        "<<ComboboxSelected>>",
        app.on_csv_file_changed
    )

    # ------------------------------------------------------------
    # Open Folder button — promoted to the tournament CSV line
    # ------------------------------------------------------------
    open_folder_btn = tk.Button(
        widget4,
        text="Open Folder",
        font=(
            default_font.cget("family"),
            default_font.cget("size")
        ),
        command=app.open_csv_folder,
        width=12
    )
    open_folder_btn.grid(
        row=1,
        column=4,
        sticky="e",
        padx=(4, 8),
        pady=2
    )

    # ------------------------------------------------------------
    # Starting game number
    # ------------------------------------------------------------
    tk.Label(
        widget4,
        text="Starting Game #:",
        font=(
            default_font.cget("family"),
            default_font.cget("size")
        ),
        anchor="w"
    ).grid(
        row=2,
        column=0,
        sticky="w",
        padx=8,
        pady=(8, 2)
    )

    app.starting_game_var = tk.StringVar(
        master=app.master,
        value=""
    )

    app.starting_game_dropdown = ttk.Combobox(
        widget4,
        textvariable=app.starting_game_var,
        values=app.game_numbers,
        state="readonly",
        width=6
    )
    app.starting_game_dropdown.grid(
        row=2,
        column=1,
        sticky="w",
        padx=(4, 8),
        pady=(8, 2)
    )
    app.starting_game_dropdown.bind(
        "<<ComboboxSelected>>",
        app.on_game_selection_changed
    )

    # ------------------------------------------------------------
    # Court CSV numbering mode
    # ------------------------------------------------------------
    tk.Label(
        widget4,
        text="This court uses numbers:",
        font=(
            default_font.cget("family"),
            default_font.cget("size")
        ),
        anchor="w"
    ).grid(
        row=2,
        column=2,
        sticky="e",
        padx=(16, 4),
        pady=(8, 2)
    )
    app.court_game_mode_dropdown = ttk.Combobox(
        widget4,
        textvariable=app.court_game_mode_var,
        values=(
            "even",
            "odd",
            "consecutive"
        ),
        state="readonly",
        width=12
    )
    app.court_game_mode_dropdown.grid(
        row=2,
        column=3,
        sticky="w",
        padx=(4, 8),
        pady=(8, 2)
    )
    app.court_game_mode_dropdown.bind(
        "<<ComboboxSelected>>",
        app.on_court_game_mode_changed
    )

    # ------------------------------------------------------------
    # Results: local file + optional third-computer synchronisation
    # ------------------------------------------------------------
    # The result filename is derived from the draw. This read-only dropdown
    # intentionally cannot select a different file to overwrite.
    sync_settings = app.load_unified_settings().get("tournamentSync", {})
    app.tournament_results_var = tk.StringVar(
        master=app.master, value="No results file"
    )
    app.tournament_results_dropdown = ttk.Combobox(
        widget4, textvariable=app.tournament_results_var,
        values=(), state="readonly", width=18
    )
    ttk.Label(widget4, text="Tournament Results:").grid(
        row=3, column=0, sticky="w", padx=8, pady=(10, 2)
    )
    app.tournament_results_dropdown.grid(
        row=3, column=1, columnspan=3,
        sticky="ew", padx=4, pady=(10, 2)
    )
    ttk.Button(
        widget4, text="Results Folder", command=app.open_csv_folder
    ).grid(row=3, column=4, sticky="ew", padx=(4, 8), pady=(10, 2))

    app.tournament_sync_mode_var = tk.StringVar(
        master=app.master,
        value=sync_settings.get("mode", "Local only")
    )
    ttk.Label(widget4, text="Results sync:").grid(
        row=4, column=0, sticky="w", padx=8, pady=2
    )
    ttk.Combobox(
        widget4, textvariable=app.tournament_sync_mode_var,
        values=("Local only", "Shared server"),
        state="readonly", width=18
    ).grid(row=4, column=1, columnspan=3, sticky="ew", padx=4, pady=2)

    app.tournament_sync_url_var = tk.StringVar(
        master=app.master,
        value=sync_settings.get("server_url", "")
    )
    ttk.Label(widget4, text="Server URL:").grid(
        row=5, column=0, sticky="w", padx=8, pady=2
    )
    ttk.Entry(
        widget4, textvariable=app.tournament_sync_url_var,
        width=30
    ).grid(row=5, column=1, columnspan=4,
           sticky="ew", padx=(4, 8), pady=2)

    app.tournament_sync_token_var = tk.StringVar(
        master=app.master, value=sync_settings.get("token", "")
    )
    ttk.Label(widget4, text="Access token:").grid(
        row=6, column=0, sticky="w", padx=8, pady=2
    )
    ttk.Entry(
        widget4, textvariable=app.tournament_sync_token_var,
        show="*", width=20
    ).grid(row=6, column=1, columnspan=3,
           sticky="ew", padx=4, pady=2)
    ttk.Button(
        widget4, text="Save & Sync",
        command=app.save_tournament_sync_configuration
    ).grid(row=6, column=4, sticky="ew", padx=(4, 8), pady=2)

    app.tournament_sync_status_var = tk.StringVar(
        master=app.master,
        value="Local results saved · network sync off"
    )
    ttk.Label(
        widget4, textvariable=app.tournament_sync_status_var,
        font=(default_font.cget("family"), small_size),
        wraplength=490, justify="left"
    ).grid(row=7, column=0, columnspan=4,
           sticky="ew", padx=8, pady=(6, 2))
    ttk.Button(
        widget4, text="Sync Now", command=app.tournament_sync.wake
    ).grid(row=7, column=4, sticky="ew", padx=(4, 8), pady=(6, 2))

    # Create/resume results immediately but never make the network a
    # prerequisite for selecting or finishing a match.
    app.on_csv_file_changed()
    app.on_use_tournament_list_changed()

    csv_comment = tk.Label(
        widget4,
        text=(
            "Tournament draw CSVs are stored in the Tournament data folder beside this program.\n"
            "The selected draw is read-only; completed games are saved locally "
            "first in a separate _Results.csv file.\n"
            "Shared-server sync sends one completed game at a time and retries "
            "every 10 seconds if the server is unavailable.\n"
            "Expected CSV headers: date,#,White,WScore,Black,BScore,"
            "Referees,Penalties,Comments\n"
            "(# is the game number; use quotes around team names containing commas)"
        ),
        font=(default_font.cget("family"), small_size),
        anchor="nw", justify="left", wraplength=600
    )
    csv_comment.grid(
        row=8, column=0, columnspan=5,
        sticky="nw", padx=8, pady=(6, 4)
    )

    # ------------------------------------------------------------
    # Manual tournament draw creator
    # ------------------------------------------------------------
    manual_draw = ttk.LabelFrame(
        widget4,
        text="Create Tournament Draw Manually",
        padding=(8, 7),
    )
    manual_draw.grid(
        row=9,
        column=0,
        columnspan=5,
        sticky="ew",
        padx=8,
        pady=(8, 10),
    )
    manual_draw.grid_columnconfigure(1, weight=1)

    ttk.Label(
        manual_draw,
        text="Draw Name:",
        font=(default_font.cget("family"), default_font.cget("size"), "bold"),
    ).grid(row=0, column=0, sticky="w", padx=(4, 8), pady=(2, 7))

    app.manual_draw_name_var = tk.StringVar(master=app.master, value="")
    ttk.Entry(
        manual_draw,
        textvariable=app.manual_draw_name_var,
        width=34,
    ).grid(row=0, column=1, sticky="w", padx=(0, 8), pady=(2, 7))

    # The table contains twenty editable rows but shows a compact viewport so
    # the current Tournament List controls remain visible above it.
    table_shell = ttk.Frame(manual_draw)
    table_shell.grid(
        row=1,
        column=0,
        columnspan=3,
        sticky="w",
        padx=4,
        pady=(0, 5),
    )

    table_canvas = tk.Canvas(
        table_shell,
        width=570,
        height=235,
        highlightthickness=0,
        borderwidth=0,
    )
    table_scroll = ttk.Scrollbar(
        table_shell,
        orient="vertical",
        command=table_canvas.yview,
    )
    table_canvas.configure(yscrollcommand=table_scroll.set)
    table_canvas.grid(row=0, column=0, sticky="nsew")
    table_scroll.grid(row=0, column=1, sticky="ns")

    table = ttk.Frame(table_canvas)
    table_window = table_canvas.create_window(
        (0, 0),
        window=table,
        anchor="nw",
    )

    def resize_manual_table(_event=None):
        table_canvas.configure(scrollregion=table_canvas.bbox("all"))

    def match_manual_table_width(event):
        table_canvas.itemconfigure(table_window, width=event.width)

    table.bind("<Configure>", resize_manual_table)
    table_canvas.bind("<Configure>", match_manual_table_width)

    header_options = {
        "font": (
            default_font.cget("family"),
            default_font.cget("size"),
            "bold",
        ),
        "anchor": "center",
        "relief": "solid",
        "borderwidth": 1,
        "padding": (4, 3),
    }
    for column, heading in enumerate(("Game number", "White", "Black")):
        ttk.Label(
            table,
            text=heading,
            width=16,
            **header_options,
        ).grid(row=0, column=column, sticky="nsew")

    def validate_manual_cell(value):
        return len(value) <= 16

    manual_validation = (
        table.register(validate_manual_cell),
        "%P",
    )

    app.manual_draw_rows = []
    for index in range(20):
        game_var = tk.StringVar(master=app.master, value=str(index + 1))
        white_var = tk.StringVar(master=app.master, value="")
        black_var = tk.StringVar(master=app.master, value="")
        app.manual_draw_rows.append((game_var, white_var, black_var))

        for column, variable in enumerate(
            (game_var, white_var, black_var)
        ):
            ttk.Entry(
                table,
                textvariable=variable,
                width=16,
                validate="key",
                validatecommand=manual_validation,
            ).grid(
                row=index + 1,
                column=column,
                sticky="nsew",
                padx=0,
                pady=0,
            )

    ttk.Label(
        manual_draw,
        text=(
            "Game numbers are editable. Game number, White and Black fields "
            "accept up to 16 characters including spaces. Empty team rows "
            "are ignored when the draw is saved."
        ),
        font=(default_font.cget("family"), small_size),
        justify="left",
        wraplength=570,
    ).grid(
        row=2,
        column=0,
        columnspan=2,
        sticky="w",
        padx=4,
        pady=(3, 4),
    )

    def save_manual_draw_from_table():
        rows = [
            (game.get(), white.get(), black.get())
            for game, white, black in app.manual_draw_rows
        ]
        try:
            draw_path, results_path = app.save_manual_tournament_draw(
                app.manual_draw_name_var.get(),
                rows,
            )
        except (OSError, ValueError) as error:
            messagebox.showerror(
                "Save Draw",
                str(error),
                parent=app.master,
            )
            return

        messagebox.showinfo(
            "Draw saved",
            (
                f"Draw saved as {Path(draw_path).name}\n"
                f"Results file: {Path(results_path).name}\n\n"
                "Both files are in the Tournament data folder."
            ),
            parent=app.master,
        )

    ttk.Button(
        manual_draw,
        text="Save Draw",
        command=save_manual_draw_from_table,
        width=14,
    ).grid(
        row=0,
        column=2,
        sticky="w",
        padx=(4, 4),
        pady=(2, 7),
    )



def create_about_tab(app, readme_path):
    """Create the About tab with credits and documentation links."""
    tab = ttk.Frame(app.notebook)
    app.about_tab = tab
    app.notebook.add(tab, text="About")

    tab.grid_rowconfigure(0, weight=1)
    tab.grid_columnconfigure(0, weight=1)

    outer = ttk.Frame(tab, padding=24)
    outer.grid(row=0, column=0, sticky="nsew")
    outer.grid_columnconfigure(0, weight=1)

    default_font = font.nametofont("TkDefaultFont")
    title_font = (
        default_font.cget("family"),
        default_font.cget("size") + 5,
        "bold"
    )
    body_font = (
        default_font.cget("family"),
        default_font.cget("size") + 1
    )
    link_font = (
        default_font.cget("family"),
        default_font.cget("size") + 1,
        "underline"
    )

    ttk.Label(
        outer,
        text="About UWH Scoring Desk",
        font=title_font
    ).grid(row=0, column=0, sticky="w", pady=(0, 18))

    ttk.Label(
        outer,
        text=f"Version {APP_VERSION}",
        font=body_font
    ).grid(row=1, column=0, sticky="w", pady=(0, 18))

    about_text = (
        "This app was started in Google AI, made workable by GitHub Copilot "
        "and extensively refactored, tweaked, improved, expanded and tested "
        "by ChatGPT. Conducted by David Stirling (who can't write code) "
        "davidstirling777@gmail.com.\n\n"
        "The conductor seems to be the star of the show, even though they do "
        "not make any noise. They even get to come on to the stage all on "
        "their own, to rapturous applause."
    )
    ttk.Label(
        outer,
        text=about_text,
        font=body_font,
        justify="left",
        wraplength=920
    ).grid(row=2, column=0, sticky="w", pady=(0, 20))

    def open_readme():
        path = Path(readme_path)
        if not path.exists():
            messagebox.showerror(
                "README not found",
                f"The README file could not be found:\n{path}"
            )
            return
        webbrowser.open(path.resolve().as_uri())

    readme_link = tk.Label(
        outer,
        text="Open the README file in this installation",
        fg="#0066cc",
        cursor="hand2",
        font=link_font
    )
    readme_link.grid(row=3, column=0, sticky="w", pady=(0, 14))
    readme_link.bind("<Button-1>", lambda event: open_readme())

    ttk.Label(
        outer,
        text="This app can be downloaded free from:",
        font=body_font
    ).grid(row=4, column=0, sticky="w")

    repository_url = (
        "https://github.com/davidstirling777-star/"
        "Underwater-Hockey-Scoring-Desk-Kit"
    )
    repository_link = tk.Label(
        outer,
        text=repository_url,
        fg="#0066cc",
        cursor="hand2",
        font=link_font
    )
    repository_link.grid(row=5, column=0, sticky="w", pady=(4, 14))
    repository_link.bind(
        "<Button-1>",
        lambda event: webbrowser.open(repository_url)
    )

    email_link = tk.Label(
        outer,
        text="davidstirling777@gmail.com",
        fg="#0066cc",
        cursor="hand2",
        font=link_font
    )
    email_link.grid(row=6, column=0, sticky="w")
    email_link.bind(
        "<Button-1>",
        lambda event: webbrowser.open(
            "mailto:davidstirling777@gmail.com"
        )
    )


def create_screen_tab(app):
    """Create the Screens tab and its operator/display layout controls."""
    tab = ttk.Frame(app.notebook)
    app.screen_tab = tab
    app.notebook.add(tab, text="Screens")

    tab.grid_columnconfigure(0, weight=1)
    tab.grid_rowconfigure(0, weight=1)

    outer = ttk.Frame(tab, padding=18)
    outer.grid(row=0, column=0, sticky="nsew", padx=12, pady=12)
    outer.grid_columnconfigure(0, weight=1)

    default_font = font.nametofont("TkDefaultFont")
    title_font = (default_font.cget("family"), default_font.cget("size") + 4, "bold")
    label_font = (default_font.cget("family"), default_font.cget("size") + 2, "bold")

    tk.Label(outer, text="Screen Configuration", font=title_font).grid(
        row=0, column=0, sticky="w", pady=(0, 14)
    )

    operator_frame = ttk.LabelFrame(outer, text="Operator Screen", padding=12)
    operator_frame.grid(row=1, column=0, sticky="ew", pady=(0, 12))
    operator_frame.grid_columnconfigure(0, weight=1)

    display_frame = ttk.LabelFrame(outer, text="Display Screen Options", padding=12)
    display_frame.grid(row=2, column=0, sticky="ew", pady=(0, 12))
    display_frame.grid_columnconfigure(0, weight=1)

    app.operator_standard_check_var = tk.BooleanVar(
        value=app.operator_layout_var.get() == "Standard"
    )
    app.operator_widescreen_check_var = tk.BooleanVar(
        value=app.operator_layout_var.get() == "Widescreen"
    )

    def choose_operator(value):
        app.operator_layout_var.set(value)
        app.operator_standard_check_var.set(value == "Standard")
        app.operator_widescreen_check_var.set(value == "Widescreen")
        app.apply_screen_configuration()

    ttk.Checkbutton(
        operator_frame,
        text="Standard (16:9)",
        variable=app.operator_standard_check_var,
        command=lambda: choose_operator("Standard"),
        style="Large.TCheckbutton"
    ).grid(row=0, column=0, sticky="w", pady=5)

    ttk.Checkbutton(
        operator_frame,
        text="Widescreen (21:9)",
        variable=app.operator_widescreen_check_var,
        command=lambda: choose_operator("Widescreen"),
        style="Large.TCheckbutton"
    ).grid(row=1, column=0, sticky="w", pady=5)

    display_options = [
        "Single Standard",
        "Single Widescreen",
        "Dual Standard",
        "Dual Widescreen",
    ]
    app.display_layout_check_vars = {
        option: tk.BooleanVar(
            value=(app.show_display_screen_var.get()
                   and app.display_layout_var.get() == option)
        )
        for option in display_options
    }

    def choose_display(value):
        # Tkinter has already toggled the clicked checkbox at this point.
        # Clicking the selected (ticked) layout again therefore turns it OFF.
        enabled = app.display_layout_check_vars[value].get()
        app.show_display_screen_var.set(enabled)
        if enabled:
            app.display_layout_var.set(value)
        # Keep the previously selected layout when disabled so it can be
        # restored next time without having to reconfigure the display.
        for option, var in app.display_layout_check_vars.items():
            var.set(enabled and option == app.display_layout_var.get())
        app.apply_screen_configuration()

    descriptions = {
        "Single Standard": "One complete 16:9 scoreboard on one external display.",
        "Single Widescreen": "One complete scoreboard sized for one 21:9 external display.",
        "Dual Standard": "Two identical complete scoreboards on two 16:9 external displays.",
        "Dual Widescreen": "Two identical complete scoreboards on two 21:9 external displays.",
    }

    for row, option in enumerate(display_options):
        line = ttk.Frame(display_frame)
        line.grid(row=row, column=0, sticky="ew", pady=4)
        line.grid_columnconfigure(1, weight=1)
        ttk.Checkbutton(
            line,
            text=option,
            variable=app.display_layout_check_vars[option],
            command=lambda value=option: choose_display(value),
            style="Large.TCheckbutton"
        ).grid(row=0, column=0, sticky="w")
        tk.Label(
            line,
            text=descriptions[option],
            justify="left",
            anchor="w"
        ).grid(row=0, column=1, sticky="w", padx=(14, 0))

    ttk.Checkbutton(
        outer,
        text="Show Team Names",
        variable=app.show_display_team_names_var,
        command=lambda: (app.toggle_display_team_names(), app.save_screen_settings()),
        style="Large.TCheckbutton"
    ).grid(row=3, column=0, sticky="w", pady=(2, 12))

    button_row = ttk.Frame(outer)
    button_row.grid(row=4, column=0, sticky="w", pady=(4, 10))

    ttk.Button(
        button_row,
        text="Auto Detect Screens",
        command=app.auto_detect_screens
    ).grid(row=0, column=0, sticky="w", padx=(0, 10))

    ttk.Button(
        button_row,
        text="Test Displays",
        command=app.test_displays
    ).grid(row=0, column=1, sticky="w")

    detected_frame = ttk.LabelFrame(outer, text="These screens were detected", padding=12)
    detected_frame.grid(row=5, column=0, sticky="ew", pady=(0, 10))
    detected_frame.grid_columnconfigure(0, weight=1)

    app.detected_screens_var = tk.StringVar(value=app.get_detected_screens_text())
    tk.Label(
        detected_frame,
        textvariable=app.detected_screens_var,
        justify="left",
        anchor="nw",
        font=("Consolas", default_font.cget("size")),
        wraplength=900,
    ).grid(row=0, column=0, sticky="ew")

    tk.Label(
        outer,
        text=(
            "Auto Detect uses the native Windows monitor list. "
            "On Raspberry Pi OS Bookworm/X11, it uses xrandr. "
            "If automatic detection is unavailable, select the screen layout manually. "
            "Test Displays labels every screen for eight seconds and can be closed "
            "by clicking or pressing Esc."
        ),
        justify="left",
        anchor="nw",
        wraplength=900,
        font=(default_font.cget("family"), default_font.cget("size"))
    ).grid(row=6, column=0, sticky="w", pady=(4, 0))
