davidstirling777-star/Underwater-Hockey-Scoring-Desk-Kit/penalties_ui.py

"""Tk penalty-entry dialog and live penalty-list interactions.

Penalties themselves live on app.engine. Listbox rows are presentation
indexes: when removing a selected penalty, resolve it against the current
stored/active collection instead of treating a row as a permanent ID.
"""

import tkinter as tk
from tkinter import ttk, messagebox


def show_penalties(app, trigger_button=None):
    """Show the penalties dialog window."""
    penalty_width = 250
    penalty_height = 450
    gap = 8

    penalty_window = tk.Toplevel(app.master)
    penalty_window.withdraw()
    penalty_window.title("Penalties")
    penalty_window.resizable(False, False)
    penalty_window.transient(app.master)

    button_frame = ttk.Frame(penalty_window, padding="10")
    button_frame.pack(side="top", fill="x")

    selected_team = tk.StringVar(value="")

    def select_team(team):
        selected_team.set(team)

        button_white.config(
            relief=tk.SUNKEN if team == "White" else tk.RAISED
        )
        button_black.config(
            relief=tk.SUNKEN if team == "Black" else tk.RAISED
        )

    button_white = tk.Button(
        button_frame,
        text="White",
        width=10,
        command=lambda: select_team("White")
    )
    button_white.pack(side="left", padx=5, expand=True)

    button_black = tk.Button(
        button_frame,
        text="Black",
        width=10,
        command=lambda: select_team("Black")
    )
    button_black.pack(side="left", padx=5, expand=True)

    numbers = list(range(1, 16))
    dropdown_options = ["Pick Cap Number"] + numbers
    dropdown_variable = tk.StringVar(value=dropdown_options[0])

    dropdown = ttk.Combobox(
        penalty_window,
        textvariable=dropdown_variable,
        values=dropdown_options,
        state="readonly",
        height=16
    )
    dropdown.pack(pady=10)

    radio_frame = ttk.Frame(penalty_window)
    radio_frame.pack(side="top", anchor="w", pady=10, fill="both")

    no_duration_selected = "__none__"
    radio_variable = tk.StringVar(value=no_duration_selected)

    tk.Radiobutton(
        radio_frame,
        text="1 minute",
        variable=radio_variable,
        value="1 minute",
        tristatevalue="__tristate__"
    ).pack(anchor="w")

    tk.Radiobutton(
        radio_frame,
        text="2 minutes",
        variable=radio_variable,
        value="2 minutes",
        tristatevalue="__tristate__"
    ).pack(anchor="w")

    tk.Radiobutton(
        radio_frame,
        text="5 minutes",
        variable=radio_variable,
        value="5 minutes",
        tristatevalue="__tristate__"
    ).pack(anchor="w")

    tk.Radiobutton(
        radio_frame,
        text="Total Dismissal",
        variable=radio_variable,
        value="Rest of the match",
        tristatevalue="__tristate__"
    ).pack(anchor="w")

    summary_frame = ttk.Frame(penalty_window)
    summary_frame.pack(side="top", fill="both", expand=True)

    ttk.Label(
        summary_frame,
        text="Stored Penalties (max 6):"
    ).pack(anchor="w")

    penalty_listbox = tk.Listbox(
        summary_frame,
        height=6,
        exportselection=0
    )
    penalty_listbox.pack(fill="both", expand=True)

    def refresh_penalty_listbox():
        selection = penalty_listbox.curselection()
        selected_index = selection[0] if selection else None

        penalty_listbox.delete(0, tk.END)

        for penalty in app.engine.active_penalties:
            if penalty["is_rest_of_match"]:
                time_str = "TOTAL DISMISSAL"
            else:
                mins, secs = divmod(penalty["seconds_remaining"], 60)
                time_str = f"{int(mins):02d}:{int(secs):02d}"

            penalty_listbox.insert(
                tk.END,
                f"{penalty['team']} #{penalty['cap']} {time_str}"
            )

        for penalty in app.engine.stored_penalties:
            already_active = any(
                active_penalty["team"] == penalty["team"]
                and active_penalty["cap"] == penalty["cap"]
                and active_penalty["duration"] == penalty["duration"]
                for active_penalty in app.engine.active_penalties
            )

            if not already_active:
                penalty_listbox.insert(
                    tk.END,
                    f"{penalty['team']} #{penalty['cap']} {penalty['duration']}"
                )

        if selected_index is not None and penalty_listbox.size() > selected_index:
            penalty_listbox.selection_set(selected_index)
            penalty_listbox.activate(selected_index)
        else:
            penalty_listbox.selection_clear(0, tk.END)

    refresh_penalty_listbox()

    def periodic_refresh():
        try:
            if penalty_window.winfo_exists():
                refresh_penalty_listbox()
                penalty_window.after(1000, periodic_refresh)
        except tk.TclError:
            pass

    penalty_window.after(1000, periodic_refresh)

    def start_penalty():
        team = selected_team.get()
        cap = dropdown_variable.get()
        duration = radio_variable.get()

        if team not in ["White", "Black"]:
            messagebox.showerror("Error", "Choose White or Black team.")
            return
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
