davidstirling777-star/Underwater-Hockey-Scoring-Desk-Kit/(commit log)

2025-09-14 Add files via upload
    This is just the bare bones of the project. All it can do is add and remove goals. It has a few space holder values and a setting tab for when a timer/game sequence gets added in.
2025-09-14 Add files via upload
    Problem when adding a new start time, the code does not update the countdown timer
    [uwh.py]
2025-09-15 Update uwh.py
    added in a heap of functionality and fixed lots of isses, still more to fix
    [uwh.py]
2025-09-16 patched timer running too fast issue
    [uwh.py]
2025-09-17 Fix sudden death goal handling to transition to Between Game Break
    [uwh.py]
2025-09-17 Implement UWH game management updates: initial period text, red background, and auto-reset
    [uwh.py]
2025-09-17 Refactor timer logic and clean up comments
2025-09-17 Fix formatting and ensure court time updates once upon app startup
    [uwh.py]
2025-09-18 Refactor timer and court time management
    Refactor timer logic to start automatically on reset and adjust court time handling.
    "Court Time" is a self-contained timer.
    After Overtime Second Half ends, if scores are tied and the sudden death checkbox is checked, the game goes into Sudden Death Game Break (not another overtime loop).
    [uwh.py]
2025-09-18 Refactor scoreboard layout and add timeout logic
    Updated font sizes and layout for scoreboard and game information display. Added timeout functionality for both teams and adjusted timer logic so it correctly counts up from local time synchronisation (synch upon app startup).
    [uwh.py]
2025-09-18 Improve timeout management and settings UI
    Refactor timeout logic and update game settings handling.
    Overtime still not being entered correctly
    [uwh.py]
2025-09-18 Refactor next_period method for clarity
    Refactor next_period method to improve readability and maintain functionality. Another attempt to get the game sequence correct.
    [uwh.py]
2025-09-18 Update default values for timeouts and overtime
    Only one countdown timer runs at once (timeouts, periods).
    After Overtime Second Half, if scores are not tied, go to Between Game Break.
    If a goal is added during Overtime/Sudden Death game break and scores are uneven, go to Between Game Break.
    If a goal is added during those breaks and scores are even, advance to Overtime First Half/Sudden Death.
    "Game Starts In:" only runs once, then cycles: Between Game Break → First Half → etc.
    After game, loops Between Game Break → First Half.
    Scores reset to zero when Between Game Break reaches 30 seconds
    Probably broke more things than I fixed
    [uwh.py]
2025-09-18 Refactor add_goal_with_confirmation method
    fixed bug where goal was added regardless of response to yes/no dialogue box
    [uwh.py]
2025-09-18 Refactor timer and game period logic
    a bit of code went stray
    File "/home/uwh/uwh.py", line 606
    if is_break:
    IndentationError: unexpected indent
2025-09-18 Improve timeout button states and sudden death logic
    also amended widgets (incorrectly!)
2025-09-18 Change button colors to light grey for consistency, and realigned buttons
    Move the Game number up, moved ref timeout button, move -ve goal white to the correct place, changed lots of colours of buttons
    [uwh.py]
2025-09-19 Add font settings for timeout buttons and scaling
    Added new font settings for timeout buttons and adjusted scaling logic for font sizes.
2025-09-19 Fix -ve goal button bugs: add confirmation dialog and remove incorrect sudden death logic
    [uwh.py]
2025-09-19 Refactor timeout button labels and add referee timeout
2025-09-20 Add penalties button, made display screen more responsive
2025-09-20 Implement tie-breaking logic and timer adjustments
2025-09-20 Implement penalty management feature
    First crack at adding code to capture penalties
    [uwh.py]
2025-09-20 Adjust score and timer label grid rowspan
2025-09-21 Implement team timeout period entry management
    Made the Court Time timer more robust
2025-09-21 made time-out buttons behave
    Refactor timeout button state management for robustness.
2025-09-21 Fix typo in README regarding Raspberry Pi 5
2025-09-21 Add check to skip score adjustment for zero
    [uwh.py]
2025-09-21 Fix indentation in adjust_score_with_confirm method
    [uwh.py]
2025-09-21 Implement penalty timer system with pause/resume functionality
2025-09-22 Refactor penalty buttons and update listbox behavior
    Refactor penalty selection buttons to use tk.Button and manage relief states. Update penalty listbox to allow item selection and auto-select the first item if present.
2025-09-23 Modify timer initialization and reset timing logic
    [uwh.py]
2025-09-24 Update timeout logic for game periods
    Reset team timeout counters at the start of each half and between game breaks. Adjusted timeout button states based on current period.
    Prevented Team Time-out in breaks,
    [uwh.py]
2025-09-24 Implement sudden death restoration and timeout tracking
    Added sudden death restoration logic and timeout tracking for teams.
    Timeout function is still not working correctly (not abutting correctly)
    [uwh.py]
2025-09-24 Tried to fix abutting timeouts (again)
    [uwh.py]
2025-09-24 Abut time-outs ('good' version of code)
    Adjusted update display interval and modified timeout handling for both teams.
    Sorted abutting of time-outs
    Time-out buttons behave
    Looks like a reasonable version of code with the limited testing done.
2025-09-24 Modify penalty window size and Close button placement
    Adjusted penalty window size and repositioned Close button.
2025-09-24 Enhance settings tab with new widgets and layout - non-working version
    Refactor settings tab layout and add new widgets for game variables and presets.
    This version has attribute errors
    [uwh.py]
2025-09-24 reverted to working version
    [uwh.py]
2025-09-25 Added periods when Penalty timers should not count down
    "Half Time",
    "Overtime Game Break",
    "Overtime Half Time",
    "Sudden Death Game Break",
    "White Team Time-Out",
    "Black Team Time-Out",
    "Referee Time-Out"
2025-09-25 Refactor penalty grid (still doesn't work) and timeout button states
    [uwh.py]
2025-09-26 Implement default CMAS rules for button configuration
    Added default values for CMAS rules in button data.
2025-09-26 Implement _apply_button_data to restore widget states
    Added method to apply saved button data and populate widgets.
    Also added Crib Time working
2025-09-26 Fix condition to shorten Between Game Break
    Updated logic to shorten Between Game Break based on court time being behind local time.
    Using Crib Time values
    [uwh.py]
2025-09-26 Add warning label for Reset Timer button
    Added a warning label above the Reset Timer button to inform users about changes.
    [uwh.py]
2025-09-27 Add sound file scanning and Play buttons to Game Variables tab
2025-09-28 Replace Sounds tab with demo implementation - complete integration
    [uwh.py]
2025-09-28 Add Zigbee2MQTT wireless siren integration with new UI tab
2025-09-28 Implement Preset button styling with ttk.Style
2025-09-28 Fix settings widget logic for checkbox/entry variables
    [uwh.py]
2025-09-28 Implement multiple Zigbee button support and fix text wrapping
    [uwh.py, zigbee_siren.py]
2025-09-28 Final implementation: Multiple Zigbee button support complete with tests
2025-09-28 Implement game sequence fix, sound timing logic, documentation, and explanation widget
    [uwh.py]
2025-09-28 Implement all four UI improvements: crib time validation, text wrapping removal, demo text removal, and audio device warning
2025-09-28 Fix sound validation to only trigger on user interaction and add sudden death game break numeric validation
    [uwh.py]
2025-09-28 Fix settings persistence to properly handle mixed checkbox/entry variables like sudden_death_game_break
    [uwh.py]
2025-09-29 Initial assessment and planning for UI improvements
    [game_data.csv, sample.csv]
2025-09-29 Implement Tournament List game number synchronization and auto-advancement
    [test_games.csv]
2025-09-29 Fix penalty display: add missing update_game_number_display call for display window
    [uwh.py]
2025-09-29 Implement Zigbee toggle button and auto-connect functionality
2025-09-29 Implement all four requested changes to uwh.py
    [test_tournament.csv]
2025-09-29 Add flag to prevent team name changes on first Between Game Break run
    [uwh.py]
2025-09-30 Optimize penalty label updates by checking current value before updating
2025-09-30 revert last two changes
    AI got them completely wrong
    [uwh.py]
2025-10-03 Update CSV headers label with correct capitalization and Penalties field
    [uwh.py]
2025-10-03 Fix preset dialog: move Sudden Death Game Break entry after checkbox, remove 'minutes' from label
    [uwh.py]
2025-10-03 Add files via upload
    Demo Data
    [tournament Draw.csv]
2025-10-03 Implement three UI improvements: Crib Time explanation, reduced preset button padding, and matched Tournament List text color
2025-10-04 Fix cap number dialog cross-platform issue by storing original button colors
    [uwh.py]
2025-10-04 Modify game sequence explanation text
    Updated explanatory text for game sequence flow.
2025-10-04 Move reset warning text into Crib Time explanation bullet group
    [uwh.py]
2025-10-04 Update Select Cap Number dialog UI with new Penalty Goal button and layout improvements
2025-10-04 Update Game Variables tab: fix pady values and row_idx for Reset Timer button
    [uwh.py]
2025-10-04 Refactor Game Variables tab to update only changed widgets
    - Created _on_single_variable_change() to update only specific variables
    - Created _update_start_first_game_in() to update only calculated field
    - Created _on_team_timeouts_change() and _on_overtime_change() for targeted updates
    - Updated all checkbox and entry event handlers to use new targeted methods
    - Avoided calling load_settings() for individual widget changes
    - Only full load_settings() called when applying presets (appropriate for batch updates)
    [uwh.py]
2025-10-05 Fix goal warning dialogs and CSV logging for breaks/timeouts, fix preset reset issue
    [uwh.py]
2025-10-05 Update and rename tournament Draw.csv to Tournament Draw.csv
    [Tournament Draw.csv]
2025-10-05 Fix game sequence: First Game Starts In now transitions directly to First Half
    [uwh.py]
2025-10-05 Fix game loop: Between Game Break now correctly loops back to First Half
    [uwh.py]
2025-10-05 Fix cap number dialog button highlighting to persist until OK is pressed
    [uwh.py]
2025-10-05 Fix period name checks to use state flags instead of hardcoded names
    [uwh.py]
2025-10-05 Fix: Between Game Break logic now works for ALL games
    [uwh.py]
2025-10-05 Fix Between Game Break duration logic to reset before applying crib time reduction
    - Reset Between Game Break duration to configured value before applying any adjustments
    - Cap crib time reduction to crib_time value (never reduce by more than crib_time)
    - Preserve minimum duration of 32 seconds (>31 sec constraint)
    - Fix applies to all entry paths: normal sequence, skipped overtime, skipped sudden death
    - Prevents accumulation of reductions across multiple games
    [uwh.py]
2025-10-05 Complete validation and testing of Between Game Break duration fix
    - All tests pass successfully
    - Verified fix works for all entry paths (normal, skip overtime, skip sudden death)
    - Confirmed duration reset, crib time capping, and minimum preservation
    - Tested consistency across multiple game entries
    - No accumulation of reductions
    [Tournament Draw.csv]
2025-10-05 Fix Reset Timer button to rebuild game sequence before updating timer
    [uwh.py]
2025-10-05 Fix Reset Timer button to rebuild game sequence before updating timer display
2025-10-05 Fix preset button logic to prevent accidental overwrites
    - Changed dialog to use default values instead of current UI values
    - Removed dead code (_apply_button_data nested function)
    - Fixed 3 locations where widget.get() was used as fallback in dialog
    - Dialog now shows preset values or defaults, never current UI values
    - Maintains correct data flow: Preset → Value Boxes on click
    [uwh.py]
2025-10-05 Change Zigbee Siren tab button text from "Test Wireless Siren" to "Test Siren via MQTT"
2025-10-05 Add referee timeout timer label feature
2025-10-05 Fix referee timeout timer: red background and frozen main timer
    [uwh.py]
2025-10-05 Implement referee timeout label and first game timer improvements
    - Set padx=0 for referee timeout timer labels in both scoreboard and display window
    - Change default referee timeout timer text from "00:00" to "Ref Time-Out"
    - Add minimum 30-second constraint for First Game Starts In period when time_to_start_first_game is blank
2025-10-06 Wrap all sound playback calls in try/except blocks to prevent timer interruption
    [sound.py, uwh.py]
2025-10-06 Fix team timeout button state management to respect checkbox
    [uwh.py]
2025-10-06 Fix bug: prevent game sequence rebuild when toggling Record Scorers Cap
    [uwh.py]
2025-10-06 Fix team_timeouts_allowed to also avoid unnecessary sequence rebuild
    [uwh.py]
2025-10-06 Fix penalty timers to pause during all break periods
    [uwh.py]
2025-10-06 Complete penalty timer fix with comprehensive testing
2025-10-06 Fix penalty timer resume bug after referee timeout during break periods
    [uwh.py]
2025-10-06 Fix penalty timer expiration bug - penalties now properly removed when countdown reaches 0
    [uwh.py]
2025-10-06 Fix Sudden Death timer continuing after goal scored
    [uwh.py]
2025-10-06 Add Open Folder button to Tournament List widget with cross-platform support
2025-10-06 Update 'Open Folder' button width to 12 characters
2025-10-06 Implement async sound playback with threading
2025-10-06 Add siren start/stop methods and update test button to use press/release events
2025-10-06 Update documentation for new press/release siren test button functionality
2025-10-06 Fix UI consistency and sound playback responsiveness
    - Add lightgrey spacer in scoreboard row 3 to match timer background
    - Replace subprocess.run with subprocess.Popen for instant Linux sound playback
    - Remove messagebox calls from sound threads to prevent UI issues
    [sound.py, uwh.py]
2025-10-06 Fix timer bug: countdown now correctly shows 2:00 when "2" is entered
    - Changed build_game_sequence to use seconds instead of minutes for time_to_start_first_game calculation
    - Removed bidirectional sync between start_first_game_in and time_to_start_first_game
    - When start_first_game_in is changed, time_to_start_first_game is cleared
    - This ensures build_game_sequence uses start_first_game_in directly without precision loss
    - All tests pass: timer correctly shows 2:00 for 2 minutes input
    [uwh.py]
2025-10-06 Validation complete: all tests pass for timer fix
2025-10-06 Fix timer countdown bug: "First Game Starts In:" field now correctly displays entered minutes
2025-10-07 Fix tkinter threading issue in sound playback
    [sound.py]
2025-10-07 Add Comments column to Tournament Draw
    Added a Comments column to the tournament draw.
    [Tournament Draw.csv]
2025-10-07 Add loop count to fallback error messages
    [sound.py]
2025-10-07 Implement siren sound looping while button is held
2025-10-07 Add documentation clarifying Zigbee button siren duration behavior
2025-10-07 Add UI clarification about Zigbee button siren duration behavior
2025-10-07 Fix penalties dialog radio buttons and timeout pip sound logic
    [uwh.py]
2025-10-07 Update timer logic to play sounds before timer changes
2025-10-07 Implement dialog positioning near trigger buttons
2025-10-08 Revert timer logic to play sounds after timer changes
    [uwh.py]
2025-10-08 Adjust timer sound logic to play before decrement
2025-10-08 Update dialog positioning to appear above trigger buttons
2025-10-08 Update dialog positioning to ensure bottom edge is always above button top
2025-10-08 Fix penalties button state after referee timeout ends
    [uwh.py]
2025-10-08 Fix penalties dialog positioning and radio button reset
    - Changed positioning logic to ALWAYS calculate based on trigger button when provided
    - Dialog bottom now always appears exactly 10px above Penalties button
    - Added explicit deselect() calls to ensure radio buttons start unselected
    - Updated positioning priority: trigger_button > saved_position > centered
    [uwh.py]
2025-10-08 Fix penalties dialog radio buttons and positioning
    - Remove individual .deselect() calls on radio buttons
    - Set shared radio_variable to empty string to ensure no button is pre-selected
    - Remove max(top_margin, ...) restriction on dialog_y positioning
    - Change winfo_reqheight() to winfo_height() to get actual dialog dimensions
    - Dialog now positions exactly 10 pixels above button without height restrictions
    [uwh.py]
2025-10-09 Replace subprocess.run with subprocess.Popen to fix Open Folder button errors
    [uwh.py]
2025-10-09 Restore Zigbee2MQTT integration details in README
    Reintroduce Zigbee2MQTT Wireless Siren Control section with detailed features and setup instructions.
2025-10-10 Replace Unicode arrow (→) with ASCII (->) in sound.py print statement
    [sound.py]
2025-10-11 Add "Open Zigbee2MQTT Frontend" button in Zigbee Siren tab
2025-10-11 Replace PM2 commands label with selectable Text widget in Zigbee Siren tab
    [uwh.py]
2025-10-14 Enhance Zigbee setup documentation with action names
    Added clarification on action names for Zigbee buttons and platform support details.
2025-10-14 Add GUI logging callback for Zigbee button events
2026-05-10 Update comment for button wiring instructions
2026-05-10 Update: Monitor pin D21 for 5V signal with LED control
2026-05-10 Add GPIO pin initialization to pull all unused pins HIGH and reduce noise
    [arduino_siren_button.ino]
2026-05-12 Change signal pin from D21 to D13 and update comments
2026-05-12 Fix siren behavior: repeat SIREN_ON every 0.5s while D13 grounded, output SIREN_OFF only when released
    [arduino_siren_button.ino]
2026-05-12 Add momentary pin pull-high to verify button still grounded without sending SIREN_OFF
2026-05-12 Reverse LED behavior: on when signalPin is low, off when signalPin is high
    [arduino_siren_button.ino]
2026-05-12 Add debouncing: require pin held LOW for 30ms before triggering SIREN_ON
2026-05-12 Add release debouncing: require pin HIGH for 30ms before triggering SIREN_OFF
2026-05-13 Fix: Remove CSV file selection check in open_csv_folder to allow opening folder without selection
    [uwh.py]
2026-05-15 Update arduino_siren_button.ino
    Added comments regarding need for pull-up resister on signal pin
2026-05-17 Rename Tournament Draw.csv to assets/Tournament Draw.csv
    [Tournament Draw.csv]
2026-06-01 Simplify PyInstaller command using spec file
    ✅ Uses only the spec file with correct assets/ paths
    ✅ Prevents PyInstaller from trying to append conflicting command-line arguments
    ✅ Cleaner and simpler build process
    ✅ Matches the local build process
2026-06-01 Fix: Correct file paths in uwh.spec - separate root and assets folders
    README.md and ZIGBEE_SETUP.md are in the repository root, not in the assets
    folder. This was causing PyInstaller build failures.
    Changes:
    - Audio files: Keep assets/ prefix (pip sounds, siren sounds)
    - Asset data files: Keep assets/ prefix (LICENSE, settings.json, Tournament Draw.csv, arduino_siren_button.ino)
    - Documentation files: Use root paths without prefix (README.md, ZIGBEE_SETUP.md)
    - Python modules: Use root paths without prefix (sound.py, zigbee_siren.py, serial_siren_listener.py)
    This matches the actual repository structure and resolves the
    "Unable to find" errors in GitHub Actions builds.
2026-06-04 Update uwh.spec
    Added import os at the top
    Changed pathex=[] to pathex=[os.getcwd()] - This tells PyInstaller to search for modules in the current working directory
2026-06-04 Update uwh.spec
    Removed os.path.abspath(__file__) which doesn't work in spec files
    Now uses os.getcwd() which returns the current working directory where PyInstaller is invoked (the repo root in GitHub Actions)
2026-06-04 Update uwh.spec
    Added explicit pip install pyinstaller to ensure PyInstaller is installed
    Added pwd and ls -la debug commands to show the working directory and files
    These will help diagnose if the directory structure issue persists
2026-06-04 Update sound.py
    Line 234: Added sound_thread.start() to the play_sound() function
    Line 235: Moved the nested function play_sound_with_volume() to be a standalone function (not nested)
    Line 318: Removed the orphaned sound_thread.start() at the end that was causing the error
    [sound.py]
2026-06-04 Update uwh.py
    Added logic to check if siren-police.mp3 exists in the available audio files
    If it exists, use it as the default siren sound
    If it doesn't exist, fall back to the first available audio file (preserving existing behavior)
    [uwh.py]
2026-06-04 Update sound.py
    Siren not staying on for duration specified
    Extract siren_duration and convert to milliseconds
    For siren sounds, use sound.play(loops=N) where N = how many times to loop
    Calculate loops based on: duration / sound_length
    This ensures the siren plays for the requested duration, looping as needed
2026-06-04 Update sound.py
    fixed bad indentation
    [sound.py]
2026-06-04 Rename Tournament Draw.csv to Tournament_Draw.csv
    [Tournament_Draw.csv]
2026-06-05 Update serial_siren_listener.py
    Fix the Port Hunting Logic for WindowsThe secondary fallback loop checks if "USB" is in port.device. On Windows, serial port devices are strictly named COM1, COM2, COM3, etc. They never contain the string "USB".Furthermore, many clone Arduinos use generic CH340 or FTDI chips that completely strip out the word "Arduino" from the description. They usually show up as "USB Serial Port (COMx)".Update find_arduino_port() to inspect the generic hardware IDs and Windows COM names:
    The Arduino Nano Every utilizes a virtual USB-to-Serial converter managed directly by its microchip. When a Python connection initializes, the physical device often forces a hardware rebo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
    [serial_siren_listener.py]
2026-06-05 Update serial_siren_listener.py
    If a user bumps the USB cord during a game, a raw while True: string-reading loop will get stuck in an infinite CPU loop or crash the thread. The code must gracefully detect disconnects and attempt an automatic reconnect
    [serial_siren_listener.py]
2026-06-05 Update uwh.py
    Ready State: It guarantees that GameManagementApp completely finishes setting up variables like self.enable_sound and its wireless siren interfaces before the hardware thread starts sending data. Crash Prevention: If the serial thread triggers a SIREN_ON event the split second the program opens, the application won't crash from a AttributeError because the functions it needs to execute are already loaded into memory.
    [uwh.py]
2026-06-05 Update serial_siren_listener.py
    pygame.mixer.get_busy(): This built-in PyGame function queries the underlying Windows audio device to check if any sound is currently playing.The Auto-Cycle Guard: When the loop checks incoming serial packets, it explicitly monitors if button_held_down and not pygame.mixer.get_busy(). If your Arduino continues to verify that the physical button is clamped down, but PyGame returns False (meaning the MP3 finished its run), Python catches the transition instantly and fires start_wireless_siren() to cycle it seamlessly.No Glitching: Because it only executes when get_busy() is False, it will never stutter at the beginning of the file while you hold the button down.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
    [serial_siren_listener.py]
2026-06-05 Update serial_siren_listener.py
    The logs show something very clear now: the code is cycling, but it is cycling way too fast (every 0.2 to 0.5 seconds).The problem is that pygame.mixer.get_busy() is immediately returning False. This happens because when you press the button, your code calls uwh_app.start_wireless_siren(). That function only sends an MQTT signal to start your physical/wireless network siren—it does not actually play the MP3 audio inside Python. Because no audio is playing inside Python, get_busy() thinks the sound is finished instantly and causes a massive rapid-fire re-trigger loop.To fix this, we need to track the audio cycle based on time (the duration of your MP3 file) r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
    [serial_siren_listener.py]
2026-06-05 Update arduino_siren_button.ino
    Changes signal pin from D12 to D3 to make it easy for wiring resistor
2026-06-05 Update serial_siren_listener.py
    No More Cut-offs: By utilizing pygame.mixer.get_busy(), Python actively waits for the speaker audio wave processing to drop to absolute zero. It will never force a loop early or cut the MP3 file short.Instant Re-triggering: The exact millisecond the track ends, if your finger is still holding down that physical button box, the guard block catches it and loops it back around for another full cycle.Clean Release: Letting go of the button immediately drops button_held_down to False, stopping the cycle instantly.
    [serial_siren_listener.py]
2026-06-06 Update serial_siren_listener.py
    fixing Fix the Double-Thread Bug in uwh.py #251
    [serial_siren_listener.py]
2026-06-06 Update uwh.py
    fixing issue use dynamic USB scanner and update Initialization Code
    #253
    [uwh.py]
2026-06-06 Update uwh.py
    removed ASCII test that was causing compilation error
    [uwh.py]
2026-06-06 Update uwh.py
    Persist detected ports to settings.json for faster future startups.
    Add a diagnostics button in the Zigbee tab to show:
    Detected ports
    Connection status
    Last successful detection time
    Document the detection logic in HARDWARE_SETUP.md for users
2026-06-06 Update uwh.py
    ✅ Splash Screen: Shows initialization progress to the user ✅ MQTT Stability Verification: Tests connection 3 consecutive times before proceeding ✅ Timeout Protection: Maximum 30-second wait to prevent hanging indefinitely
    ✅ Graceful Fallback: Allows app to continue if MQTT unavailable ✅ Logging: Detailed console output for debugging ✅ Connection Guarantee: Audio and hardware detection only start after MQTT is proven stable ✅ Race Condition Prevention: Eliminates timing issues between startup components
    [uwh.py]
2026-06-07 Update uwh.py
    test_siren_btn.bind("<ButtonPress-1>", lambda event: self.start_wireless_siren())
    test_siren_btn.bind("<ButtonRelease-1>", lambda event: self.stop_wireless_siren())
    These methods no longer exist! They should call the controller methods instead
    test_siren_btn.bind("<ButtonPress-1>", lambda event: self.zigbee_controller.start_siren_continuous())
    test_siren_btn.bind("<ButtonRelease-1>", lambda event: self.zigbee_controller.stop_siren_continuous())
    [uwh.py]
2026-06-07 Update uwh.py
    ✅ Added self.display_window.winfo_exists() check
    ✅ Wrapped in try/except for safety
    ✅ Loop automatically stops when window closes
2026-06-07 Update uwh.py
    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
    [uwh.py]
2026-06-08 Update uwh.py
    testing for two classes error
    [uwh.py]
2026-06-09 Update uwh.py
    Added debugging for penalties not clearing issue
    [uwh.py]
2026-06-10 Update uwh.py
    eliminated display-window crash path
    [uwh.py]
2026-06-13 Update uwh.py
    Added Startup checks:
    ✓ Game Engine loaded
    ✓ Settings loaded
    ✓ Sounds preloaded: 7
    ✓ Arduino: COM6
    ✓ Zigbee: COM7
    ✓ MQTT: Connected
    ✓ Serial listener active
2026-07-11 Enhance settings UI with display detection features
    Added buttons for testing displays and auto-detecting screens, along with a label frame to show detected screens.
2026-08-05 Use DISPLAY_GREY constant for background color
    Refactor display UI to use a constant for background color and improve layout stability.
    [display_ui.py]
2026-08-05 Enhance penalty grid background handling
    Added error handling for penalty grid background configuration and ensured consistent background color.
    [display_ui.py]
2026-08-05 Implement presentation timer formatting and updates
    Added functions to format and manage presentation timer text, ensuring proper display without leading zeros. Updated the display logic to use the new timer formatting.
2026-08-05 Implement size validation for UI elements
    Add size checks for UI components before updating current size.
2026-08-05 Refactor timer display and font configuration
    Refactored timer display to use a frame for layout and updated font handling.
2026-08-05 Implement fixed timer panel for presentation
    Added a fixed timer panel with custom font settings for the presentation timer.
    [display_ui.py]
2026-08-06 Update label text in settings UI
    Removed the label for 'CSV File' and replaced it with 'This court uses numbers:' in the settings UI.
    [settings_ui.py]
2026-08-06 Update fmt.Println message from 'Hello' to 'Goodbye'
2026-08-06 Fix formatting of dismissal return string
    [display_manager.py]
2026-09-26 Implement clean exit functionality with confirmation
    Added a method to confirm and cleanly exit the application from Raspberry Pi, including stopping the connection watchdog and Zigbee controller.
2026-09-26 Add exit button to Game Variables tab
    Added exit button to the Game Variables tab for program termination.
2026-09-26 Enhance debugging with print statements in uwh.py
    Added debug print statements to track application flow during startup and exit.
2026-09-26 Implement thread-safe Zigbee status handling
    Added thread-safe queue for Zigbee status updates and processing method.
2026-09-27 Update README with Raspberry Pi 5 setup instructions
    Added detailed instructions for Raspberry Pi 5 configuration and installation, including performance observations with X11 and Wayland.
2026-09-27 Update README with Raspberry Pi 5 configuration details
    Added details about Raspberry Pi 5 setup and X11 performance observations.
2026-09-27 Update hardware setup details and X11 instructions
    Corrected voltage range for initial setup and added instructions for using X11 on Raspberry Pi 5.
2026-09-28 Prevent reopening presentation on empty display selection
    Handle empty display selection without reopening presentation window.
    [display_ui.py]
2026-09-28 Enhance siren management and error handling
    Refactor siren control methods and improve error handling.
    [uwh.py]
2026-09-28 Implement timed siren playback with volume control
    Added a function to start a timed wireless siren with volume control, ensuring it plays for a specified duration and handles errors appropriately.
    [sound.py]
2026-09-28 Set Arduino siren channel volume to maximum
    Ensure the Arduino siren channel volume is set to maximum when playing.
2026-09-28 Update display layout logic in display_ui.py
    Refactor display layout handling to prevent reopening hidden Display Screen.
    [display_ui.py]
2026-09-28 Update README with Windows 11 and Raspberry Pi 5 details
    Added Windows 11 configuration details and clarified Raspberry Pi 5 setup information.
2026-09-28 Enhance wireless siren control with cycle support
    Refactor wireless siren functionality to support multiple cycles and improve handling of sound events.
2026-09-28 Fix condition to check entry widget before getting value
    [preset_manager.py]
2026-09-29 Refactor startup self-test and update comments
    Removed installation status report from startup self-test and added comments about MQTT broker and Zigbee2MQTT.
    [uwh.py]
2026-09-29 Preserve completed game state when CSV export fails
    [game_flow.py]
2026-09-29 Atomically replace settings.json and archive previous version with timestamp
    [settings_manager.py]
2026-09-29 Show recoverable error for non-UTF8 settings documents
    [settings_manager.py]
2026-09-29 Apply saved siren cutoff to game tests, timer and Zigbee timed actions
2026-09-29 Test configurable ten-second default siren cutoff and wireless playback
2026-09-29 Restore Arduino ON/OFF forwarding on ZigbeeSirenController
2026-09-29 Forward Arduino siren independently of PC mute and log playback errors
    [uwh.py]
2026-09-29 Use UWH settings location and reject Zigbee serial ports as Arduino
2026-09-29 Expose received Arduino ON/OFF events in UWH siren log
2026-09-29 Report when the Arduino serial listener actually opens its COM port
2026-09-29 Test Arduino serial classification and independent local/MQTT ON-OFF routing
2026-09-29 Display serial open or error status in Arduino siren GUI log
    [uwh.py]
2026-09-29 Queue Arduino serial connection and error diagnostics for GUI
    [serial_siren_listener.py]
2026-09-29 Test Arduino serial open and error messages reach GUI log
2026-09-29 Log discarded Zigbee button actions and explicit Ignore mappings
2026-09-29 Test emergency action diagnostics for unlisted and ignored Zigbee buttons
2026-09-29 Avoid saving unchanged COM ports on every hardware scan
    [serial_siren_listener.py]
2026-09-29 Avoid fresh settings backup for unchanged startup hardware detection
    [hardware_detection.py]
2026-09-29 Verify configured MQTT broker and CONNACK during startup
    [startup_selftest.py]
2026-09-29 Pass saved MQTT broker and credentials to startup self-test
    [uwh.py]
2026-09-29 Test BOM, quoted commas/newlines, and CSV export round-trips
2026-09-29 Atomically replace tournament draw after a complete flushed CSV write
    [csv_export.py]
2026-09-29 Record three tested Zigbee buttons in README.md
2026-09-29 Record three tested Zigbee buttons in ZIGBEE_SETUP.md
2026-09-29 Clarify settings_ui.py instructional labels without changing device handling
2026-09-29 Clarify zigbee_hardware_ui.py instructional labels without changing device handling
2026-09-29 Clarify zigbee_ui.py instructional labels without changing device handling
2026-09-29 Explain Tk composition, timer callbacks and export-failure invariants
    [uwh.py]
2026-09-29 Regress tested-button documentation and corrected UI status/help labels
2026-09-29 Clarify three-button limit and update operator instructions to match current UWH
2026-09-29 Explain observed three-button setup, mappings and current Zigbee troubleshooting
2026-09-29 Clarify README.md tested-action scope and three-button wording
2026-09-29 Clarify MAINTAINERS.md tested-action scope and three-button wording
2026-09-29 Update documentation checks for three-button wording and current mapping help
2026-09-29 Skip redundant Tk penalty layout operations and remove unused sync wrapper
    [uwh.py]
2026-09-29 Remove unreferenced external penalty sync timer
2026-09-29 Cover protected draw, results persistence, collisions, mismatch and Pi sample seeding
2026-09-29 Document read-only tournament draw, saved results and Raspberry Pi sample seeding
2026-09-29 Address failing regression: uwh.py
    [uwh.py]
2026-10-02 Expect unity app volume for Arduino siren
2026-10-02 Fix restored sound slider row layout
    [sounds_ui.py]
2026-10-02 Restore Arduino siren volume test
2026-10-02 Document Pi 5 GPIO 5A power configuration
2026-10-02 Expand Raspberry Pi 5 power configuration guidance
2026-10-02 Clarify sound filename filtering and remove obsolete Air/Water note
2026-10-02 Complete Scoreboard goal button documentation
2026-10-02 Expand Zigbee button naming examples
2026-10-02 Add Zigbee2MQTT device naming screenshot
2026-10-02 Redesign Sounds tab with per-file trim tables
    [sounds_ui.py]
2026-10-02 Update sample settings for per-file sound trims
2026-10-02 Update Arduino siren test for per-file trim
2026-10-02 Build Windows and Raspberry Pi 5 release packages
2026-10-02 Document ready-to-run Raspberry Pi 5 release
2026-10-04 Add three empty default preset slots
2026-10-04 Avoid duplicate Game Variable checkbox callbacks
    [settings_ui.py]
2026-10-04 Keep configured-device counts synced with mappings
2026-10-04 Refresh configured Zigbee devices after saving
2026-10-04 Clear all Sudden Death state on manual timer reset
    [uwh.py]
2026-10-04 Fix deciding-goal retraction to use engine Sudden Death state
    [uwh.py]
2026-10-04 Keep a single Sudden Death timer implementation
2026-10-04 Document v1.3.3 Sudden Death timer fix
2026-10-04 Guard v1.3.3 Sudden Death timer wiring
2026-10-04 Pin ttkbootstrap to compatible 1.x API
2026-10-04 Keep all overtime values visibly disabled with shared switch
2026-10-04 Retain classic fixes in settings_manager.py
    [settings_manager.py]
2026-10-04 Retain classic fixes in preset_manager.py
    [preset_manager.py]
2026-10-04 Retain classic fixes in game_flow.py
    [game_flow.py]
2026-10-05 Correct preset manager documentation
    [preset_manager.py]
2026-10-05 Let Auto-add discover unlisted Zigbee buttons safely
2026-10-05 Make Auto-add include newly observed Zigbee buttons
2026-10-05 Document Auto-add discovery of new Zigbee buttons
2026-10-05 Document fail-closed new-button Auto-add
2026-10-05 Test Auto-add observation of unlisted Zigbee buttons
2026-10-05 Add regression tests for new-button Auto-add
2026-10-05 Keep Sounds folder comments current
2026-10-15 docs: replace obsolete prototype hardware guide with current RP5 audio setup
2026-10-15 docs: require stereo TRS cable to Pool Audio Rev 2 and specify official DAC+ for production
2026-10-15 docs: record LG 24MP400-B powered by motherboard PDM via custom cable
2026-10-15 docs: record 19 V PDM supply to LG monitor via custom cable
2026-10-15 docs: confirm working RP5 Zigbee and describe modified waterproof referee button
2026-10-16 docs: document tested centre-positive LG 19 V lead and remove unreleased hardware history
2026-10-17 test: verify warning selection, trim and milliseconds save independently
2026-10-18 Add monotonic deadline timer to prevent accumulated GUI delay
2026-10-29 Document successful Raspberry Pi 5 tournament use
2026-11-05 docs: recommend tested Aqara WXKG11LM siren button
2026-11-05 docs: retain tested-button qualification required by regression check
2026-11-06 docs: clarify Pi 5 wired siren and untested shared-broker deployments
2026-11-06 docs: replace Aqara purchase link with device specifications
2026-11-06 docs: describe modified UWH referee button construction
2026-11-08 Add split-board KiCad hardware and assembly guide
2026-11-09 Add UWH siren enclosure STEP files and translucent PETG guidance
2026-11-09 Revise README for clarity on hardware and software
    Updated README to clarify hardware and software details, including PCB requirements and assembly instructions.
2026-11-09 Document Arduino Nano Every siren sketch installation
2026-11-09 Support Nano ESP32 ADC and pin mapping alongside Nano Every
2026-11-09 Document installation for both Nano Every and Nano ESP32
2026-11-09 Define supply cable voltage-drop test and corrective actions
2026-11-09 Document installed 30 metre Cat 6a siren button cable
2026-11-09 Illustrate siren cable storage with a spearfishing line winder
2026-11-09 Add Harwin M20-1070600 Pi harness connector example
2026-11-10 Update README with material and pipe details
    Clarified material requirements and pipe specifications in README.
2026-11-10 Revise wireless siren adaptor and set bundled siren duration to 1.5 seconds
2026-11-10 Document Aqara button wiring, strain relief and battery packing
2026-11-10 Add expanded wireless siren battery wiring and foam packing photo
2026-11-10 Refresh hardware setup for DAC+ and current split-board design
2026-11-12 Confirm successful DN15 test fit of screw-hole-free adaptor (#316)
    * Restore exact physically fit-tested DN15 pipe adaptor
    * Keep screw-hole-free adaptor and document successful DN15 test fit
2026-11-12 Update control board from 12 November KiCad project upload
2026-11-12 Replace control PCB with corrected supplied version
